ricklon/cam-rotation-starter/drives/n20/cad/stl/README.md

# N20 print files

Exported from the Fusion design *Cam Rotation N20* and oriented for printing (z = 0 is the bed) by [`../fusion/orient_stl.py`](../fusion/orient_stl.py). All files are binary STL in millimetres. `raw/` (not in git) holds the same parts in the model's coordinates.

<!-- parts -->
| Part | Orientation | Size on bed (mm) | Bed contact (mm²) |
|---|---|---|---|
| N20_Mount | flange (wall face) down | 109.0 × 47.2 × 48.6 | 3506 |
| N20_Bushing_075 | flange down | 34.0 × 29.0 × 6.0 | 478 |
| N20_Bushing_0625 | flange down | 34.0 × 29.0 × 6.0 | 574 |
| N20_Bushing_025 | flange down | 34.0 × 29.0 × 6.0 | 765 |
| N20_Cartridge | on its side (-x face down), arms flat along the bed | 35.3 × 29.0 × 15.0 | 282 |
| N20_Electronics_Cover | top plate down, walls and posts up | 42.0 × 55.2 × 12.5 | 2031 |
| N20_Socket_Coupon | socket coupon: plate top down, as the mount | 20.5 × 27.0 × 12.4 | 318 |
| N20_Latch_Key | flat on its side, the U on the bed | 12.2 × 16.7 × 7.0 | 109 |
| N20_Control_Pod | front panel down, open back up | 39.2 × 38.0 × 24.0 | 955 |
| N20_PETG_Fit_Coupon | flat side down, labels up | 100.0 × 44.0 × 6.5 | 3085 |
| N20_Mount_Fit_Coupon_Wall | mount fit coupon: wall top down, as the mount | 32.0 × 11.2 × 36.4 | 192 |
| N20_Mount_Fit_Coupon_Base | mount fit coupon: base inside face down, underside up as on the mount | 37.5 × 35.2 × 4.0 | 1026 |
| N20_Mount_Fit_Coupon_Pod | mount fit coupon: pod front panel down, as the pod | 10.0 × 19.0 × 24.0 | 171 |
| N20_Adapter_075 | D-bore end down, socket up | 25.4 × 25.4 × 24.0 | 462 |
| N20_Adapter_0625 | D-bore end down, socket up | 22.2 × 22.2 × 24.0 | 347 |
| N20_Adapter_025 | D-bore end down, socket up | 12.6 × 12.6 × 24.0 | 99 |
| N20_Adapter_Clamp_0625 | 5/8 clamp, D-bore end down | 26.5 × 24.3 × 24.0 | 347 |
| N20_Adapter_Clamp_025 | 1/4 clamp, socket end down (more bed contact) | 19.9 × 16.3 × 24.0 | 130 |
| N20_Adapter_075_Sleeved | 3/4 sleeved, D-bore end down | 26.5 × 26.5 × 24.0 | 507 |
| N20_Clamp_0625_cap | 5/8 clamp cap, split face down | 26.5 × 17.5 × 12.5 | 163 |
| N20_Clamp_025_cap | 1/4 clamp cap, split face down | 19.9 × 17.5 × 9.2 | 218 |
<!-- /parts -->

Parts the N20 drive shares with the MG90S drive aren't repeated here. Print them from [`drives/mg90s/cad/stl`](../../../mg90s/cad/stl/README.md): `Panel_Fit_Coupon`, the bushings, the dowel gauges and the shims. The N20 drive now has its own control pod (`N20_Control_Pod`, with the J3 connector holder) and its own clamp caps (flat counterbores for M3 cap heads).

**Updated 2026-10-26 (Fusion *Cam Rotation N20* version 10).** Reprint everything in this folder except the plain adapters (`N20_Adapter_075`, `_0625`, `_025`, `_075_Sleeved`), which didn't change. What's new: the motor cartridge, the 14 mm capacitor seat, the diode channel under the base, zip-tie anchors, cap-head clamps, the pod's connector holder, and the PETG fit coupon. `N20_Fit_Coupon` is retired: the cartridge itself and the PETG coupon cover what it tested.

**Added 2026-10-26 (version 11): `N20_Mount_Fit_Coupon_Wall`, `_Base` and `_Pod`,** pieces of the real mount and pod that check the capacitor, diode, board, cartridge, zip-tie and connector fits before the long prints. Nothing else changed.

**Updated 2026-10-27 (version 13): `N20_Mount` only.** The slot between the base and the N20 plate, open at both ends, is now solid, so supports can't get trapped in it (sliced on an A1 with build-plate supports: none there now, and the print drops from about 3 h to 2 h 50 min; 6.6 g more PETG). The cartridge socket and its M3 pilots still cut through it. The wall and base coupon files changed by the same fill. **This fill was wrong until version 19:** see below.

**Updated 2026-10-27 (version 14): snap-fit motor and cartridge.** Reprint `N20_Cartridge` (it now prints on its side) and `N20_Mount` (latch pockets in the socket). New: `N20_Socket_Coupon`, the mount round the socket, to test the latch before the mount. No screws are needed; see [Snap-fit motor](../../README.md#snap-fit-motor-2026-10-27).

**Updated 2026-10-27 (version 15): all six adapters and clamps** (`N20_Adapter_075`, `_0625`, `_025`, `_075_Sleeved`, `_Clamp_0625`, `_Clamp_025`; the caps didn't change). Each has an M3 × 5 set screw that presses on the motor shaft's flat: a 2.5 mm pilot from the bore, with a 3.4 mm access hole to the outside, 2.8 mm above the D-bore end.

**Updated 2026-10-27 (version 16): tighter, locked snap fit.** Reprint `N20_Cartridge`, `N20_Socket_Coupon` and `N20_Mount`. The hooks are set for a 24.1 mm motor (measured), 1.2 mm deep and barbed, with ribs for a zip tie that locks the arms; the latch bumps are 1.4 mm with a steep lower face, in deeper pockets. See [Snap-fit motor](../../README.md#snap-fit-motor-2026-10-27).

**Updated 2026-10-27 (version 18): hard catch on the cartridge latch.** Reprint `N20_Cartridge`, `N20_Socket_Coupon` and `N20_Mount`, and print the new `N20_Latch_Key` (4 min). The latch bumps now have a square catch face, the socket is 0.1 mm tighter a side (`cart_clear` 0.2 mm), and the pockets the bumps click into are now slots open to the top of the base, where the key goes in to release the cartridge. The hooks, arms and zip tie didn't change. Printed and tested on 2026-10-27: the latch holds. See [Snap-fit motor](../../README.md#snap-fit-motor-2026-10-27).

**Fixed 2026-10-27 (version 19): the base-plate slot fill.** From version 13 to 18 the fill started at the bottom of the base instead of its top, so it filled in everything already cut into the base: the DRV8833 pocket and the relief under its pins, the diode channel and its lead slot, and the wire channel under the base on the pod side. It also reached 1.3 mm into the side walls and closed the end of one control pod screw pilot. Now it fills only the slot, from the top of the base to the N20 plate, between the walls. Reprint `N20_Mount`, and `N20_Mount_Fit_Coupon_Base` if you test the board fits with it. A mount printed from version 13–18 files has no DRV8833 pocket or diode channel. `N20_Socket_Coupon` and `N20_Mount_Fit_Coupon_Wall` changed slightly at their edges; ones you've printed still test the same fits. Sliced on an A1 with build-plate supports: none in the slot, the DRV8833 pocket or the diode channel.

**Updated 2026-10-27 (version 20): wiring only, print files unchanged.** The zip ties at anchors A1 and A2 are now modelled in place, and W14 and W15 are routed through A2, so they're cut 55 and 65 mm (were 50 and 60).

**Fixed 2026-11-03 (version 36): `N20_Electronics_Cover` only, mirrored to fit the real board.** The model had the perfboard as its own mirror image (row 1 at +X with column A toward the box wall can't happen on a real board seen from its component side), so covers from versions 33–35 fit RV1 and C3 but had everything else at the wrong end. Now row 17 and both USB-C ports are at −X: the open end, the C1 hole, the posts and the motor notch have moved to match, and the knob hole and C3 hole sit where RV1 and C3 really are. The mount needs no change (all four supports have pilots). Reprint only the cover. W14, W15, W6 and W11 are rerouted, so their cut lengths changed (80, 90, 185 and 185 mm).

**Updated 2026-11-03 (version 34): `N20_Electronics_Cover` again, with the measured sizes.** RV1's shaft is 5 mm above the board and its bushing reaches 5 mm past the board edge, so the knob hole moved down and an Ø11.5 × 0.8 mm recess round it on the outside gives the M7 nut and washer 3.5 mm of thread. C3 is an 8 × 13 mm can like C1, through a 9 mm hole. Reprint the cover from this version.

**Updated 2026-11-08 (version 38): `N20_Cartridge` only.** Both snap hooks now stop 24.8 mm below the gearbox face, so an N20 with a Hall encoder board on its back (the board's front face is about 25 mm from the gearbox face) fits. The −Y arm stops at the same height, because the encoder board runs under it. The catch is unchanged, but the sloped lead-in under each hook is gone: spread the arms with your fingers as the motor goes in. The plain N20 still fits. See [Encoder motor](../../README.md#encoder-motor-2026-11-08). The wire clamp below the +Y arm stays on the part but isn't used with the encoder motor: its cable plugs into the encoder, so nothing is soldered at the motor.

**Updated 2026-11-08 (version 39): wiring only, print files unchanged.** The encoder motor's cable, the links W30 and W31 and C2 on the perfboard are routed in the model. The cable comes out through the cover's existing 7 mm notch.

**Updated 2026-11-09 (version 41): `N20_Cartridge` only, fingers round the encoder board.** The version 38 print wouldn't clip over the encoder motor: its hooks had to drop into a gap of under 1 mm between the end cap and the board, which sits tilted 25–25.5 mm from the gearbox face. Now the −Y arm has no end-cap hook. Instead, two fingers (1.2 mm wide, split from the arm up to 15 mm below the gearbox face) pass the board's sides, 0.3 mm clear, and catch its back 26.6 mm from the gearbox face, 0.8 mm in, with a sloped lead-in, so they spread as the board goes past. The +x finger's catch is tapered at 45° so it prints without supports. The +Y arm keeps its end-cap hook, now with a 0.5 mm lead-in again (more would hit the board). The fingers flex across the layers, unlike the arms; the strain is under 1 %, but if one snaps, tell me. Clearances: 0.2 mm to the board, 0.3 mm to the magnet cap. With the plain N20 (no board), only the +Y hook holds it.

**Updated 2026-11-03 (version 35): `N20_Mount` only.** The bushing's flange recess has moved from the underside of the top plate to the flat wall face: the bushing drops into the bore from the wall side, its Ø34 mm double-D flange sits in a 1.6 mm deep recess (flange 1.5 mm, so it sits 0.1 mm below the face), and the box wall holds it in once the mount is screwed on. Nothing has to slide in under the plate any more, where the 5/8 clamp left no room. The old recess under the plate is filled. Bore (Ø29.2 mm), bushing and dowel bores are unchanged, so the bushings don't need reprinting; reprint only the mount. The recess is on the bed face: its ceiling is a 2.6 mm ring overhang round the bore, which prints without supports. The box wall hole now only needs to pass the dowel: the dowel and its clamp go through the mount, then the bushing, before the mount goes on the wall (see the [assembly order](../../README.md#assembly-order-and-tool-access)). The MG90S drive has the same change (*Cam Rotation Starter* version 51).

**Updated 2026-11-03 (version 33): `N20_Electronics_Cover` only.** Fitted to the board as built: RV1 stands with its shaft parallel to the board, pointing off the J edge, and C3 stands. The cover's J-edge wall moved in to just past RV1's face and carries the Ø7.2 mm knob hole; the top has a notch for RV1's body and a hole for C3's top; the C1 hole, the USB-C opening, the posts and the motor notch stay. It still prints top plate down with no supports (the knob hole is a horizontal Ø7.2 mm hole in a wall). RV1 and C3 sizes are assumed until measured: see `cad/fusion/cover_rv1.py`.

**Updated 2026-11-02 (version 31): `N20_Mount` and the new `N20_Bushing_075`, `_0625`, `_025`.** the mount's top-plate bore is Ø29.2 mm so the assembled 5/8 clamp, with its M3 cap heads (14.3 mm swept), drops through from above. The N20 bushings are Ø29.0 mm outside with a Ø34 mm double-D flange (flats 28.8 mm apart, parallel to the side walls), retained from below. (From 2026-11-03 the MG90S drive has the same bore and bushings, so they're a shared part again; `N20_Bushing_*` here and the MG90S `Bushing_*` are the same.) Dowel bores unchanged. Box wall hole: Ø20 mm is enough if the dowel and clamp go through the mount before it's screwed to the box; to push them in from inside the box with the drive already mounted, the box hole needs ≥ Ø29.2 mm (a 30 mm bit). Print the bushings from either folder.

**Updated 2026-11-02 (version 30): `N20_Control_Pod` and `N20_Mount_Fit_Coupon_Pod`.** The direction switch and the J3 panel connector are gone, so the pod has no JST header holder; the button's wires run straight to the perfboard. The holder was what needed tree supports in the pod: slice it and check before you turn supports off. Skip `N20_Mount_Fit_Coupon_Pod` now: it only checked the holder.

**Updated 2026-11-02 (version 29): `N20_Mount`, `N20_Electronics_Cover` and `N20_Mount_Fit_Coupon_Wall`.** C1 now stands on the perfboard, so the capacitor seat in the mount's −Y wall is gone (filled in), and the cover has a 9 mm hole for the can's top. The wall coupon is cut from the mount, so it lost the seat too; ignore the capacitor checks below.

**Updated 2026-11-01: `N20_Cartridge` only.** The wire clamp is sized for the motor's own leads (assumed 26 AWG, about 1.0 mm) instead of 30 AWG: the bar between its two zip-tie slots is 2.4 mm (was 1.4 mm), and the plate is 1 mm longer so the lower slot keeps a 1 mm edge. Reprint the cartridge.

**Updated 2026-10-31 (version 25): rev C.** Reprint `N20_Mount` and `N20_Cartridge`, and print the new `N20_Electronics_Cover`. The socket and mount fit coupons didn't change.

- **`N20_Mount`:** supports for the perfboard on the −Y face: two posts from the flange, two bosses with 45° gussets, and a rail past the face's +X edge, all with M2 pilots. The flange ear is unchanged.
- **`N20_Cartridge`:** a wire clamp plate below the +Y snap arm, with two slots for a 2.5 mm zip tie (for the plain N20's soldered leads; the encoder motor doesn't use it).
- **`N20_Electronics_Cover`:** goes over the perfboard as the mount's outer −Y wall, open at the −X end for both USB-C plugs, and carries the speed knob.

The supports print up from the flange without supports of their own. See [What changed on 2026-10-31](../../README.md#what-changed-on-2026-10-31-rev-c).

## Test prints, in order

Each step checks something before you commit to a longer print. Print these in PETG if that's what the full build will be: PETG holes come out a little different from PLA's.

### 1. `N20_PETG_Fit_Coupon` (about 15 g)

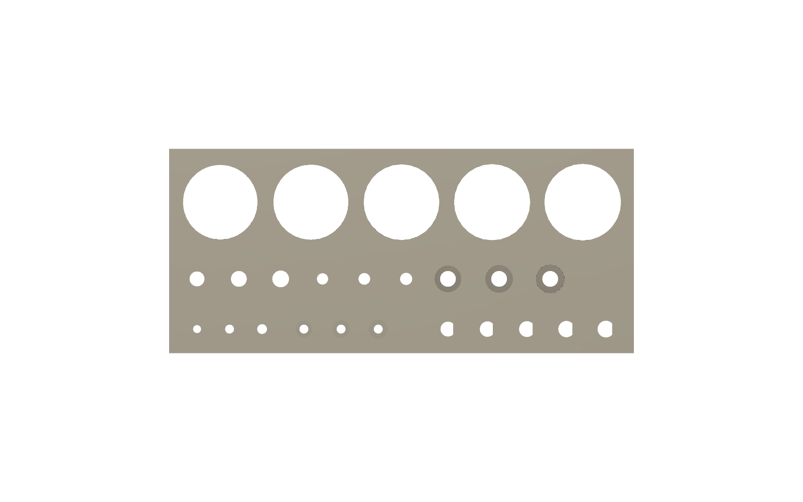
[picture p5: drives/n20/docs/images/petg_fit_coupon.png]
The PETG fit coupon from above: five large 5/8" holes along the top, a row of M3 holes below them, and a strip of small M1.6 holes and D-shaped bores along the bottom, each with its size engraved underneath.


Every hole has its size engraved under it. Find the one that fits in each row and note it.

| Row | Labels | Check | Then set |
|---|---|---|---|
| 5/8" dowel | +0.2 … +0.6 (mm over 15.875) | The hole the dowel **slides and turns in** freely is the bushing clearance; the one it **pushes into snugly** is the adapter socket clearance. | `hole_clear` (0.5) and `fit_clear` (0.3) |
| M3 clearance | C3.2, C3.4, C3.6 | The smallest an M3 screw drops through. | `clamp_clear` and `cart_m3_clear` (3.4) |
| M3 pilot | P2.4, P2.5, P2.6 (6.5 mm deep) | Drive an M3 × 8 in: it should cut its thread firmly without splitting the plastic. | `clamp_pilot` (also the adapters' shaft set screw) and `cart_m3_pilot` (2.5) |
| M3 cap head | H5.8, H6.0, H6.2 (3.2 mm deep) | The socket cap head drops in and sits flat, flush or just below. | `clamp_cbore` (6.0) |
| M1.6 clearance | 1.7, 1.9, 2.1 (in the 3 mm strip) | The smallest an M1.6 screw drops through. | `m16_clear` (1.9) |
| M1.6 counterbore | c3.6, c3.8, c4.0 (1.5 mm deep) | Pan head on a split lock washer sits flush. | `m16_cbore` (3.8) |
| D-bore | .10 … .30 (clearance per side) | Push the motor shaft in, flat to flat: the one that goes on by hand without wobble. | `n20_bore_clear` (0.15) |

### 2. `N20_Cartridge`, `N20_Socket_Coupon` and `N20_Latch_Key` (about 22 + 15 + 4 min, 3 + 5 + 1 g)

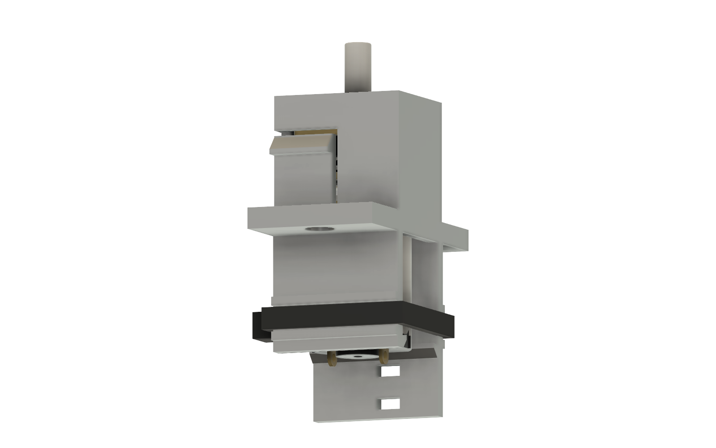
[picture p6: drives/n20/docs/images/cartridge.png]
The cartridge with the motor in it, from the side: the shaft out of the top plate, a latch tongue cut into the side wall with its bump near the top, the flange, and below it a snap arm along the motor with its hook over the end cap, and a black zip tie round both arms between their ribs.


Print them the way they load, with no supports: the cartridge lies on its side, the socket coupon on its plate face like the mount, the key flat. The coupon is the mount's own socket, cut out of it, so a latch that holds here holds in the mount. The catch face in each slot prints as a short bridge. **The cartridge needs no supports; turn them off for it.** Most of its overhang is one flat ceiling, the far wall of the gearbox cavity, which prints as a 10.6 mm bridge across the inside of the tube. Everything else is a short bridge (the zip-tie slots, the 0.5 mm slots beside the encoder fingers) or a 45° slope. Standard (grid) supports fill the motor cavity and the finger slots and are close to impossible to get out. If your bridge sags and you want support under it, use organic (tree) supports from the build plate only, and if your printer has a second material, print the support interface in PLA: PLA doesn't bond to PETG, so it peels off. **Before printing, measure your motor** from the gearbox face to the back of the end cap. The hooks are set for 24.1 mm (`n20_len`), so tell me if yours differs.

| Check | If it's wrong |
|---|---|
| The motor pushes up into the cartridge until its gearbox face meets the top plate, and both arms click over the end cap. It shouldn't rattle up and down. | Won't click: the motor is longer than `n20_len`. Rattles: it's shorter. Measure it and tell me. Gearbox tight in the sleeve: raise `n20_clear` (0.3 mm). |
| Pulling the motor down (without the zip tie) doesn't release it: the barbed hooks hold. Spreading both arms by hand does, without the arms whitening or staying bent. | Releases on a pull: tell me, the barb or hook depth can grow. Arms whiten: they can be made longer or thinner. |
| A 2.5 mm zip tie sits between the two ribs on the arms (the dark band in the picture above) and, pulled tight, stops them spreading at all. | Tie slips over a rib: tell me, the ribs can be taller. |
| The **empty** cartridge pushes up into the socket coupon until both latches click and the flange sits flat, with almost no up-and-down or side-to-side play. Looking down into the two slots in the top, you can see both bumps. | Too stiff or won't click: tell me how it felt; the bumps or the tongue slits can change. Won't go in at all: the socket is too tight for your printer; `cart_clear` can go back up. |
| **Pull test, empty:** hold the coupon and pull the cartridge down hard by its flange. It shouldn't come out. | It comes out: tell me whether the bumps or the ledges in the slots look rounded or crushed. |
| **Pull test, motor in:** fit the motor and zip tie, then hang about 1 kg (a full 1 L water bottle) from the motor, or pull on it as hard as you would in class. Nothing moves. | It comes out: tell me which gave way: the bumps, the ledges, or the motor out of the cartridge. |
| **Release:** motor out, push the key down into both slots until it stops; the cartridge then slides out of the socket from below with a light pull. | Key won't go in: the slots or prongs are tight; tell me. Cartridge still holds: the key isn't pressing the tongues in far enough; tell me. |

### 3. `N20_Mount_Fit_Coupon_Wall`, `_Base` and `_Pod` (about 13 g together)

Three pieces cut from the real mount and pod in Fusion (boxes intersected with them, so they follow every change to either). Together they check every fit on the long prints before you commit to them.

**Print each file the way it loads; don't use lay flat or auto-orient.** Each piece is already the same way up as the full part it comes from, which is what makes its holes and pockets come out the same size: the wall piece stands on the top of the wall (like the mount, flange down), the base piece lies on the base's inside face with its underside up (as on the mount), and the pod piece stands on its front panel (like the pod). Turning them over to get more bed contact would test the wrong thing.

| File | Supports | Time on an A1 (PETG, 0.2 mm) |
|---|---|---|
| `N20_Mount_Fit_Coupon_Wall` | none | about 32 min |
| `N20_Mount_Fit_Coupon_Base` | none | about 16 min |
| `N20_Mount_Fit_Coupon_Pod` | **tree supports, allowed on the model** (not build plate only): the connector holder starts in mid-air over the front panel | about 16 min |

| Piece | Check | If it's wrong |
|---|---|---|
| Wall piece | The capacitor snaps into its seat. The XIAO drops into its pocket, with its soldered wire ends in the 2.5 mm relief under each pin row. The PD board drops into its seat on the pad and rests on the 1 mm ledge, its bottom-side parts clear of the recess floor. Your zip ties go through the XIAO's and the PD board's slots, and round the bar in anchor A1 at the bottom of the wall. | Capacitor: `c1_seat_dia`. Boards: `board_clear` (0.3 mm), `solder_relief_d` (2.5 mm), `pd_relief_d` (3.5 mm). |
| Base piece | The motor cartridge slides through the socket (here only the 4 mm base) and its flange sits flat on the base; the M3 pilots line up with the flange holes (their depth is tested on the PETG coupon). The DRV8833 drops into its pocket with its wire ends in the relief. The diode lies in its channel with its lead in the slot to the DRV8833 pocket. A zip tie goes round the bar in anchors A1 and A2. | Cartridge: `n20_clear`, `cart_m3_pilot`. DRV8833: `board_clear`, `solder_relief_d`. |
| Pod piece | Nothing from version 30: it only checked the JST-PH header holder, which is gone. | Skip it. |

### 4. `Panel_Fit_Coupon` and the dowel gauges (from the MG90S folder)

Skip these if you've done them for the MG90S drive. Follow steps 1 and 3 of the [MG90S print order](../../../mg90s/cad/stl/README.md#print-order-for-a-fit-test).

### 5. One adapter for your dowel

Print the adapter for the dowel you'll use (`N20_Adapter_075`, `_0625` or `_025`; the clamp version plus its cap if the dowel is sanded). Check that it slides onto the motor shaft with the flat lined up, and that the dowel pushes into the socket snugly. Then drive the M3 × 5 set screw in with a 1.5 mm hex key: it should cut its thread and pinch the shaft's flat so the adapter can't turn on it, without stripping.

### 6. `N20_Mount` and `N20_Control_Pod` (the long prints)

Only once steps 1, 2, 3 and 5 fit. The fit coupon has already checked the fits below; on the full mount, look for the things a coupon can't show: the face plate bridged cleanly, the flange is flat, and the PD pad's overhang printed cleanly. Then check the mount after printing:

- the empty cartridge clicks up into the socket in the base and its flange sits flat under the base;
- the capacitor snaps into its seat beside the XIAO pocket;
- the diode lies in the channel under the base, and its lead slot runs from the wall edge to the DRV8833 pocket;
- the zip-tie anchors are open: two small slots with a bar between them, joined by a tunnel inside the base, under the electronics-side wall (A1) and beside the DRV8833 pocket on the pod side (A2). They're the only tie holes under the base; the two round holes beside the socket are the M3 pilots for the optional cartridge screws;
- the DRV8833 pocket and the 2.5 mm relief slots under its pin rows (and under the XIAO's) are clean;
- the PD board drops into its seat in the pad and rests on the 1 mm ledge round its edges.

In the pod, check that the button fits its hole. (Up to version 29 the pod also had a holder for the J3 header; it's gone.)

### What to send back

Tell me which hole fitted in each row of the PETG coupon, how the cartridge snaps felt, how each part sat in the mount fit coupon, and anything that was tight or loose. I'll set the parameters in Fusion and re-export.

## Suggested settings

| Part | Material | Layer | Walls | Infill | Supports |
|---|---|---|---|---|---|
| N20_PETG_Fit_Coupon | PETG | 0.2 mm | 3 | 20% | none |
| N20_Cartridge | PETG (not PLA: the arms, fingers and latch tongues flex) | 0.16 mm | 3 | 40% | **none**: printed on its side (as the file loads), so the snap arms and latch tongues bend along their layers (the encoder fingers bend across them, gently). See the cartridge notes in section 2 if your slicer adds supports. |
| N20_Socket_Coupon | PETG | 0.2 mm | 3 | 25% | none (same settings as the mount) |
| N20_Latch_Key | PETG | 0.16 mm | 3 | 40% | none: printed flat, as the file loads |
| N20_Mount_Fit_Coupon_Wall, _Base | PETG | 0.2 mm | 3 | 25% | none (same layer, walls and infill as the mount, so its fits come out the same) |
| N20_Mount_Fit_Coupon_Pod | PETG | 0.2 mm | 3 | 20% | **tree supports, allowed on the model**, as for the pod |
| Adapters, clamps, caps | PETG | 0.12–0.16 mm | 4 | 40% | none |
| N20_Control_Pod | PETG | 0.2 mm | 3 | 20% | **tree supports, allowed on the model** (not build plate only): printed front panel down, the JST holder starts in mid-air above the front panel's inside face |
| N20_Mount | PETG | 0.2 mm | 3 | 25% | **yes**, build plate only: under the face plate (through the bushing hole) and the PD pad. The ear bosses print upright from the flange and need none. |
| N20_Electronics_Cover | PETG | 0.2 mm | 3 | 20% | none: printed top plate down, as the file loads |

PETG notes: print a little slower and hotter than PLA, turn off ironing, and use a glue stick or textured sheet on smooth PEI (PETG can bond too well). Where a part needs supports, organic (tree) supports come off far more easily than standard ones, and with a two-material printer a PLA support interface (or all-PLA supports) separates cleanly from PETG. Holes usually come out slightly smaller than in PLA, which is what the coupon is for.

Printed flange down, the mount's face plate is a 29 mm bridge between the side walls, now with the cartridge socket through it. The supports under it stand in the open space the adapter turns in and come out through the open ends; the narrower slot above the plate, under the base, is filled solid so nothing gets trapped there. If yours sags, turn on supports everywhere (not just from the build plate) for that print. The PD board's pad also leaves a 3.5 mm overhang facing the bed; build-plate supports reach it.

## Fitting the motor, the driver and the panel

The full order, with the tool for each step, is in the drive's [assembly order](../../README.md#assembly-order-and-tool-access).

- **Motor:** no screws. The empty cartridge clicks up into the socket in the base, then the motor pushes up into the cartridge, its shaft into the adapter's D-bore, until the arms click over its end cap, and a zip tie round the arms locks it. The M1.6 counterbores and M3 flange holes are still there if a snap ever needs backing up with screws.
- **Shaft set screw:** one **M3 × 5** set screw in every adapter and clamp, near the D-bore end, tightened onto the shaft's flat with a 1.5 mm hex key through an open end of the mount once the motor is in.
- **Clamps:** two **M3 × 8** socket cap screws per clamp, heads in the flat counterbores on the cap. Turn the cap toward an open end of the mount to reach them with a 2.5 mm hex key. With the screws tight, the 5/8 clamp sweeps 14.3 mm from the axis, inside the 0.6 mm relief in both side walls (15.3 mm). Don't use M3 × 10: on the 5/8 clamp the tip would come out of the side.
- **DRV8833 module:** solder its wires first, then stick it into the pocket on the underside of the base with a square of double-sided foam tape, component side out. Leave its **J1** jumper open.
- **Diode:** lay it in its channel under the base with the banded end toward the wall, bend the cathode lead round the edge and up to the XIAO's 5V pad, and run the anode lead along its slot to the DRV8833's VCC pin. A dab of glue holds it.
- **Capacitor:** from version 29, C1 stands on the perfboard (see [perfboard.md](../../docs/perfboard.md#placement)); the mount has no seat for it.
- **Control panel connector (J3):** gone from version 30. The button's two wires run straight to the perfboard (see [wiring.md](../../docs/wiring.md#the-button-s1)).
- **Zip ties:** one through anchor A1 round the two power wires under the wall, one through A2 round the two motor wires under the base, and one round the cartridge's motor arms between their ribs.
