ricklon/cam-rotation-starter/drives/n20/docs/images/perfboard.png

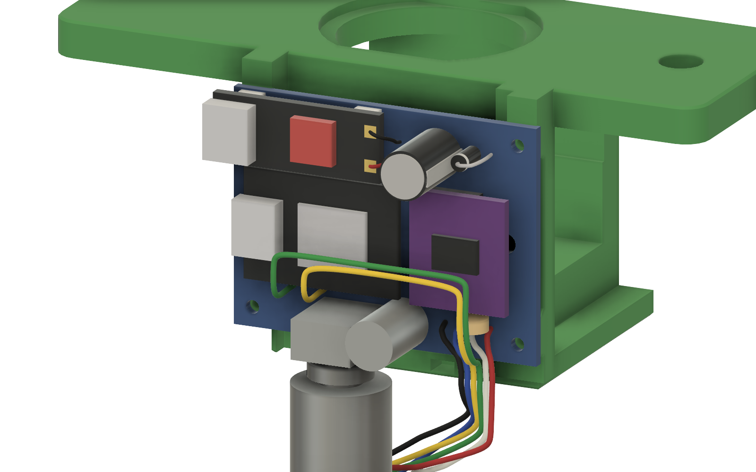
drives/n20/docs/images/perfboard.png
