ricklon/cam-rotation-starter/drives/mg90s/cad/stl/Servo_Mount.stl

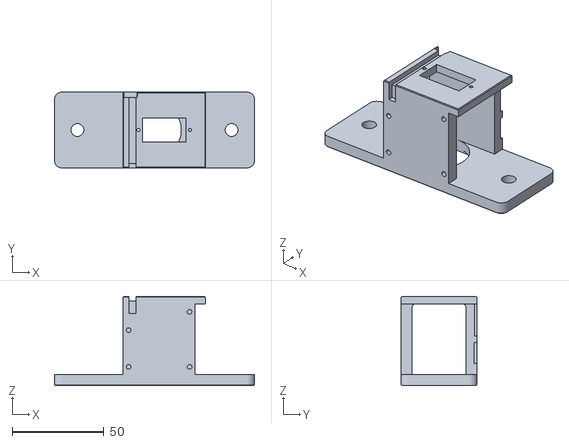
[picture p10: CAD file, 2026-11-03]
drives/mg90s/cad/stl/Servo_Mount.stl
109.0 x 41.3 x 48.6
