ricklon/cam-rotation-starter/drives/n20/cad/solidcraft/pipeline/v22/fusion_ref/Adapter_075_Sleeved.step

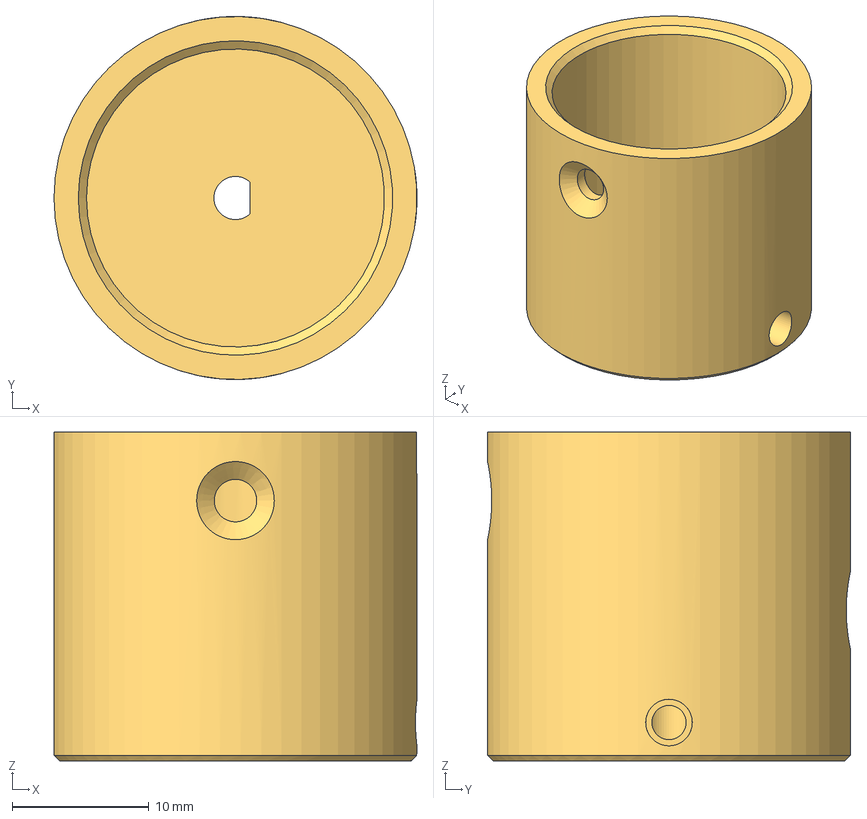
[picture p11: CAD file, 2026-10-29]
drives/n20/cad/solidcraft/pipeline/v22/fusion_ref/Adapter_075_Sleeved.step
26.5 x 26.5 x 24.0 mm
