ricklon/cam-rotation-starter/drives/n20/cad/solidcraft/repros/06_fusion_Adapter_025.step

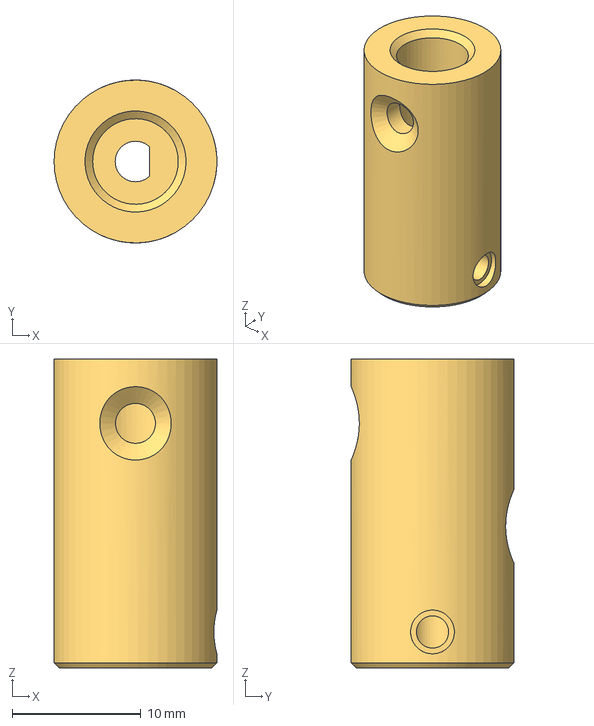
[picture p12: CAD file, 2026-10-29]
drives/n20/cad/solidcraft/repros/06_fusion_Adapter_025.step
12.6 x 12.7 x 24.0 mm
