ricklon/cam-rotation-starter/drives/n20/cad/step/cam-rotation-n20.step

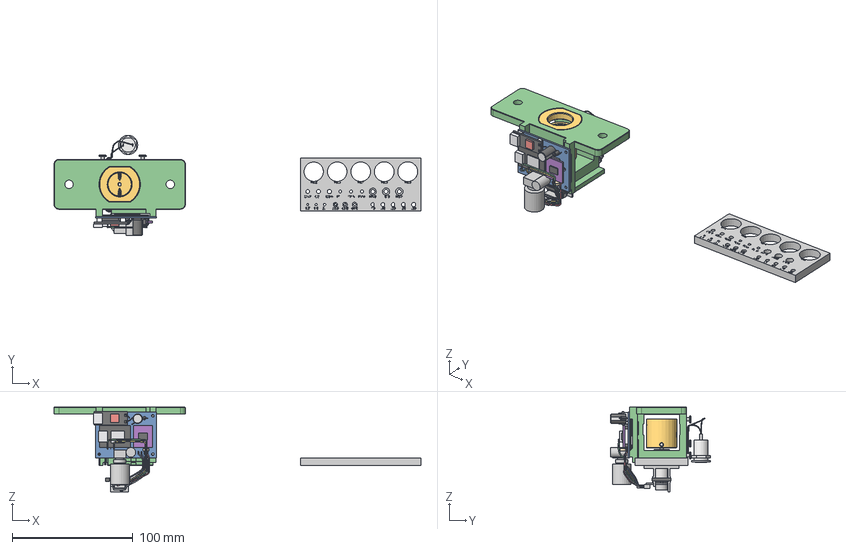
[picture p13: CAD file, 2026-11-10]
drives/n20/cad/step/cam-rotation-n20.step
304.5 x 83.3 x 70.5 mm
M3x8 Wafer Head v1 (3).step x 4
N20 DC MOTOR
