ricklon/cam-rotation-starter/drives/n20/cad/stl/N20_Cartridge.stl

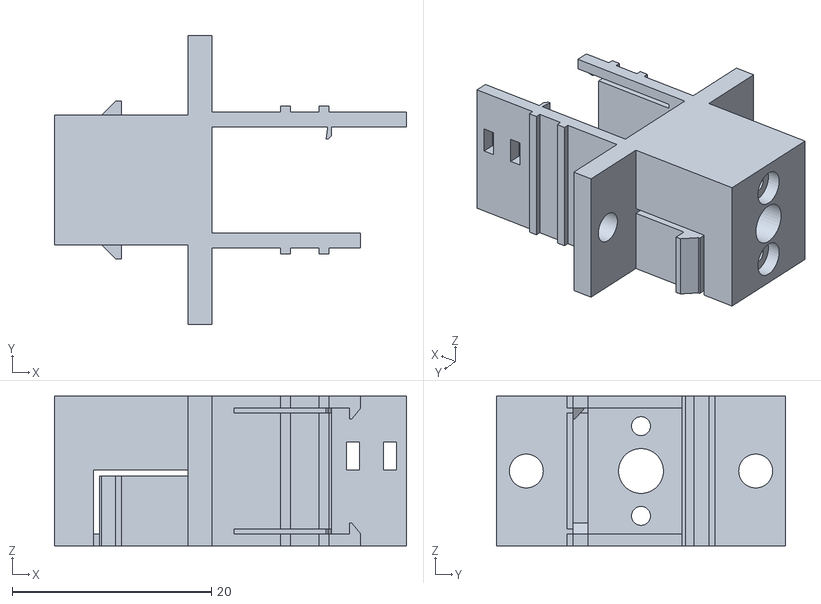
[picture p14: CAD file, 2026-11-10]
drives/n20/cad/stl/N20_Cartridge.stl
35.3 x 29.0 x 15.0
