ricklon/cam-rotation-starter/drives/mg90s/cad/stl/Bushing_075.stl

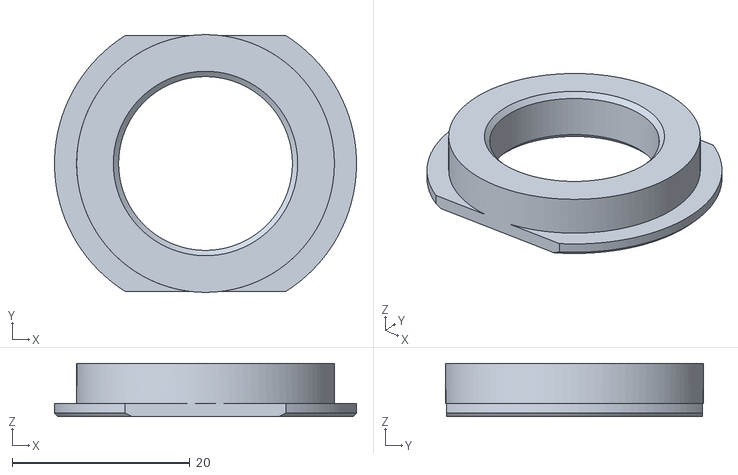
[picture p15: CAD file, 2026-11-03]
drives/mg90s/cad/stl/Bushing_075.stl
34.0 x 29.0 x 6.00
