ricklon/cam-rotation-starter/drives/n20/cad/solidcraft/pipeline/v22/fusion_ref/Servo_Mount.step

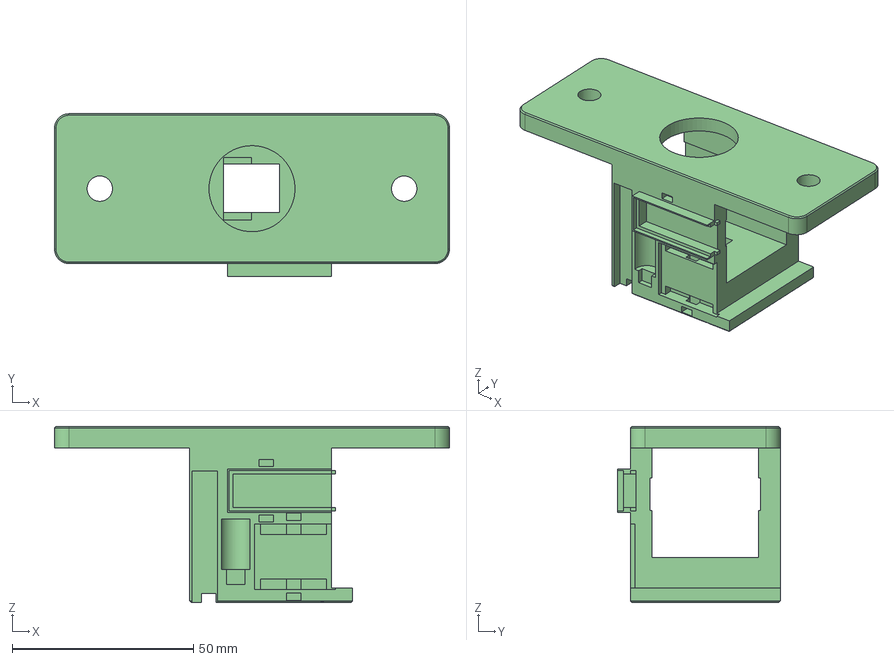
[picture p16: CAD file, 2026-10-29]
drives/n20/cad/solidcraft/pipeline/v22/fusion_ref/Servo_Mount.step
109.0 x 44.8 x 48.6 mm
