ricklon/cam-rotation-starter/drives/n20/cad/stl/N20_Electronics_Cover.stl

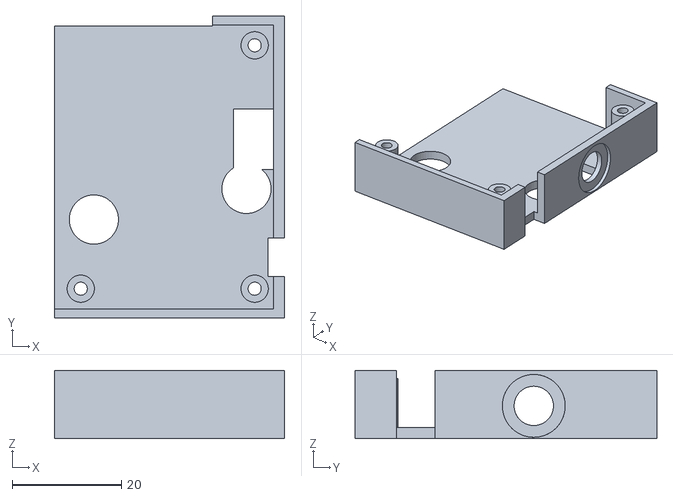
[picture p17: CAD file, 2026-11-03]
drives/n20/cad/stl/N20_Electronics_Cover.stl
42.0 x 55.2 x 12.5
