ricklon/cam-rotation-starter/drives/n20/cad/solidcraft/pipeline/v22/fusion_ref/Adapter_075.step

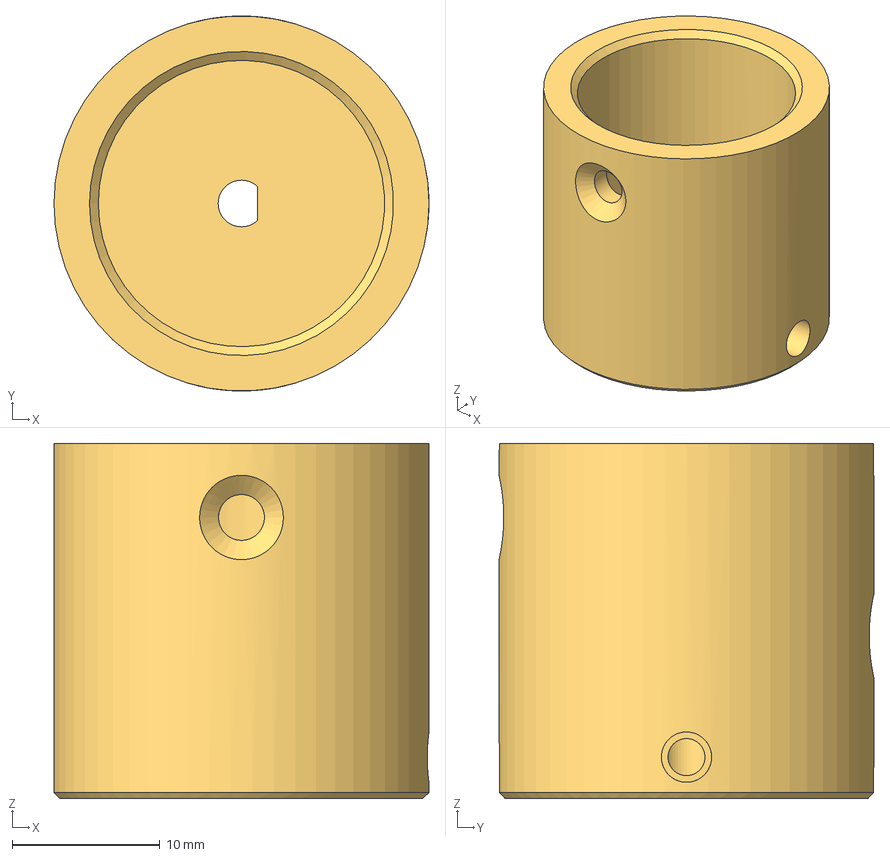
[picture p19: CAD file, 2026-10-29]
drives/n20/cad/solidcraft/pipeline/v22/fusion_ref/Adapter_075.step
25.4 x 25.3 x 24.0 mm
