ricklon/cam-rotation-starter/drives/n20/cad/stl/N20_Mount.stl

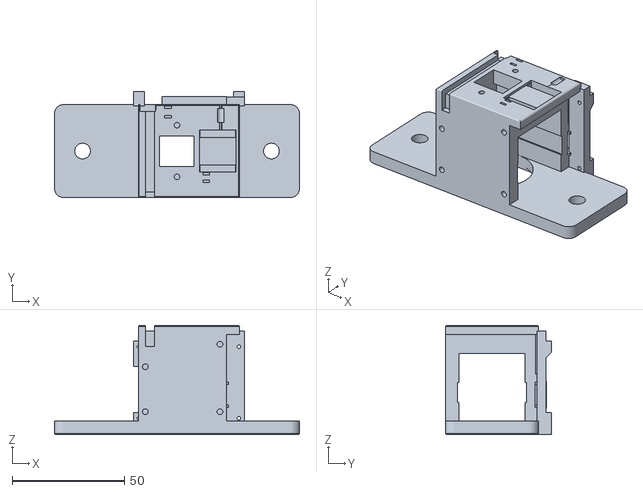
[picture p20: CAD file, 2026-11-03]
drives/n20/cad/stl/N20_Mount.stl
109.0 x 47.2 x 48.6
