ricklon/cam-rotation-starter/drives/n20/cad/solidcraft/pipeline/v22/fusion_ref/N20_Cartridge.step

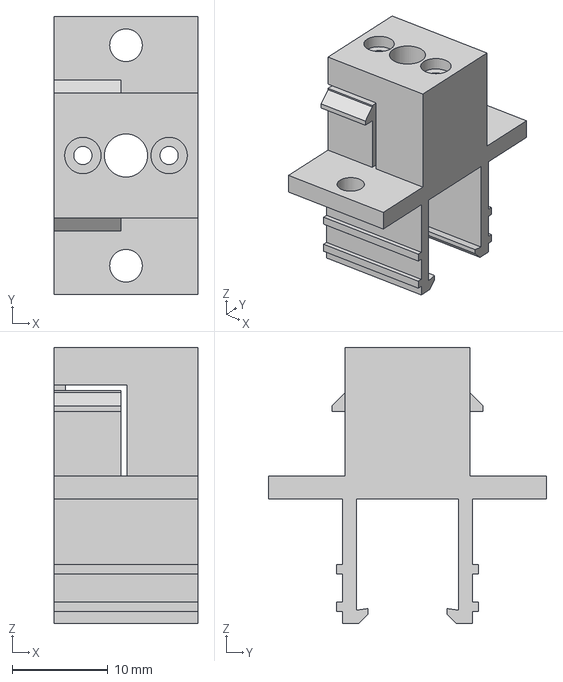
[picture p22: CAD file, 2026-10-29]
drives/n20/cad/solidcraft/pipeline/v22/fusion_ref/N20_Cartridge.step
15.0 x 29.0 x 28.8 mm
