ricklon/cam-rotation-starter/drives/n20/cad/stl/N20_Mount_Fit_Coupon_Wall.stl

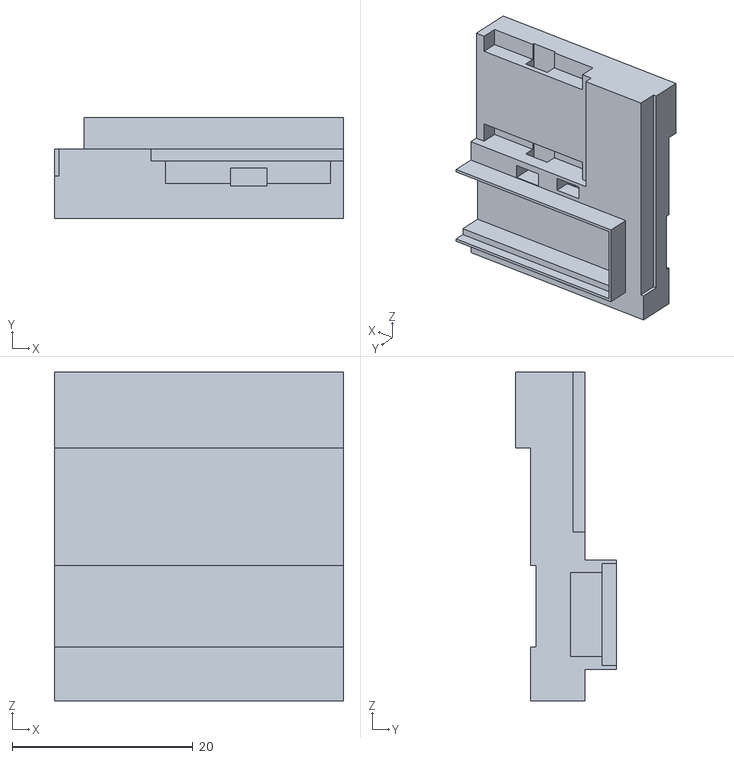
[picture p23: CAD file, 2026-11-03]
drives/n20/cad/stl/N20_Mount_Fit_Coupon_Wall.stl
32.0 x 11.2 x 36.4
