ricklon/cam-rotation-starter/drives/mg90s/cad/stl/Adapter_Clamp_0625.stl

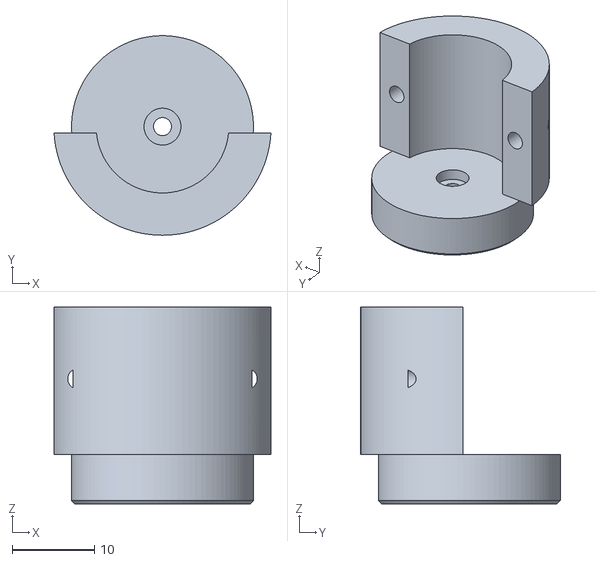
[picture p24: CAD file, 2026-10-24]
drives/mg90s/cad/stl/Adapter_Clamp_0625.stl
26.5 x 24.3 x 24.0
