ricklon/cam-rotation-starter/drives/n20/cad/solidcraft/pipeline/v22/fusion_ref/N20_Latch_Key.step

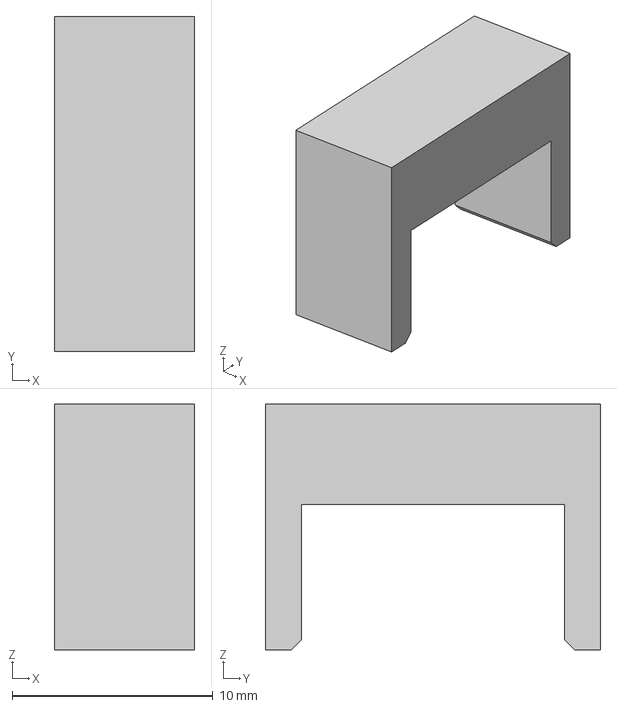
[picture p25: CAD file, 2026-10-29]
drives/n20/cad/solidcraft/pipeline/v22/fusion_ref/N20_Latch_Key.step
7.00 x 16.7 x 12.2 mm
