ricklon/cam-rotation-starter/drives/n20/cad/stl/N20_Mount_Fit_Coupon_Pod.stl

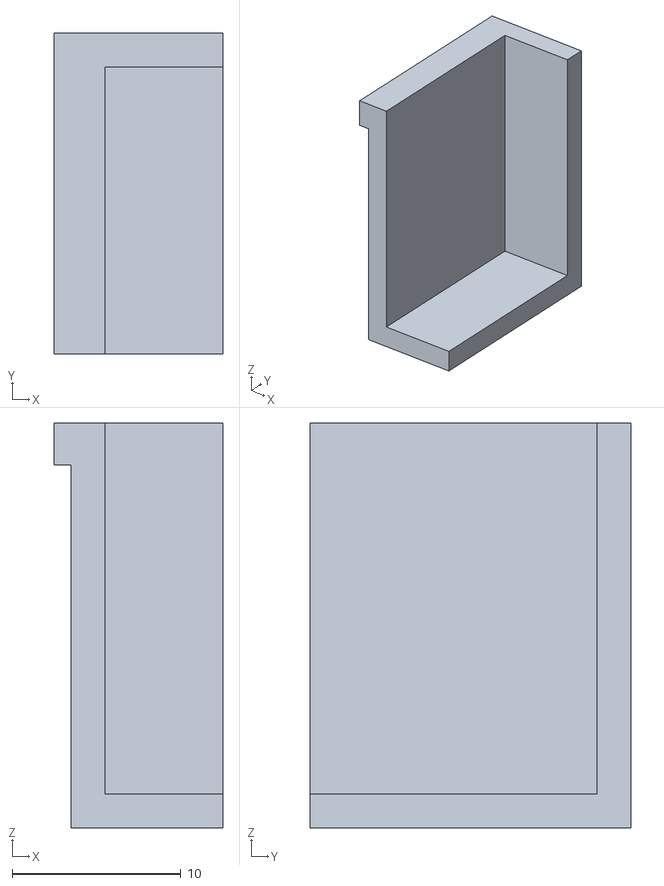
[picture p26: CAD file, 2026-11-03]
drives/n20/cad/stl/N20_Mount_Fit_Coupon_Pod.stl
10.0 x 19.0 x 24.0
