ricklon/cam-rotation-starter/drives/mg90s/cad/stl/Clamp_0625_cap.stl

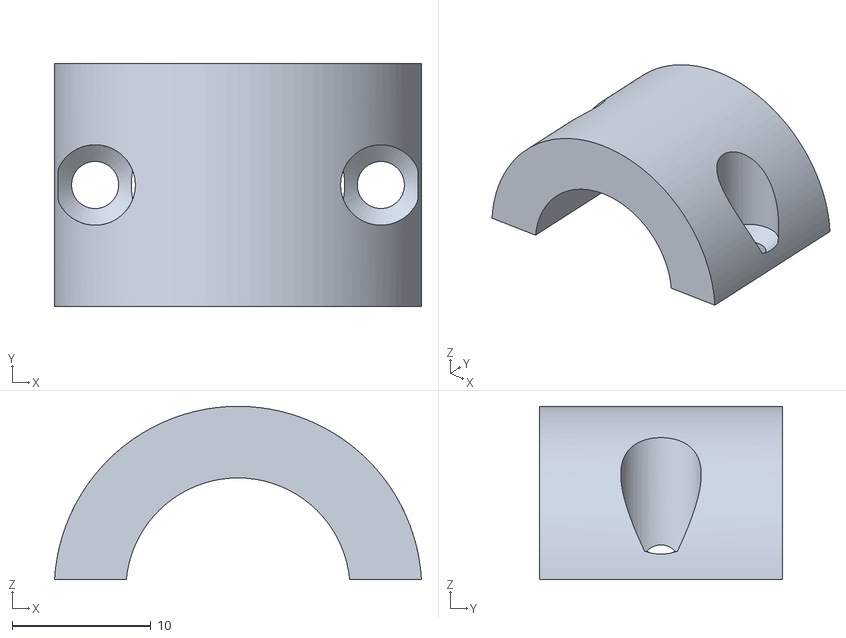
[picture p27: CAD file, 2026-10-24]
drives/mg90s/cad/stl/Clamp_0625_cap.stl
26.5 x 17.5 x 12.5
