ricklon/cam-rotation-starter/drives/n20/cad/solidcraft/pipeline/v22/fusion_ref/Adapter_Clamp_0625.step

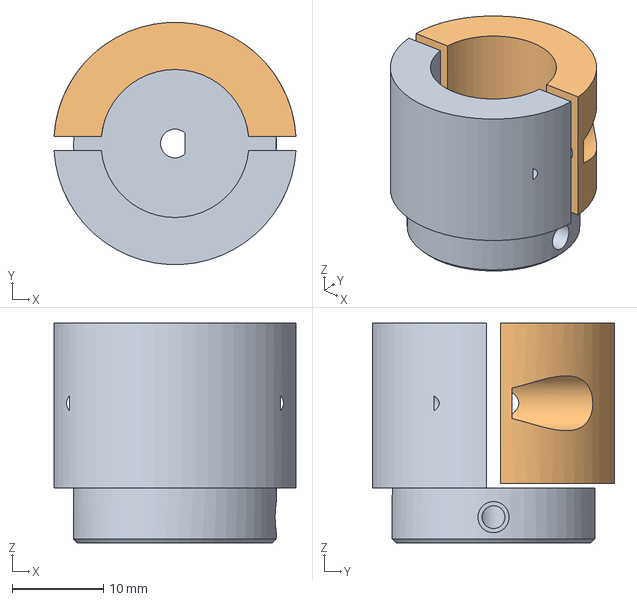
[picture p28: CAD file, 2026-10-29]
drives/n20/cad/solidcraft/pipeline/v22/fusion_ref/Adapter_Clamp_0625.step
26.5 x 26.5 x 24.0 mm
