ricklon/cam-rotation-starter/drives/mg90s/cad/stl/Adapter_Clamp_025.stl

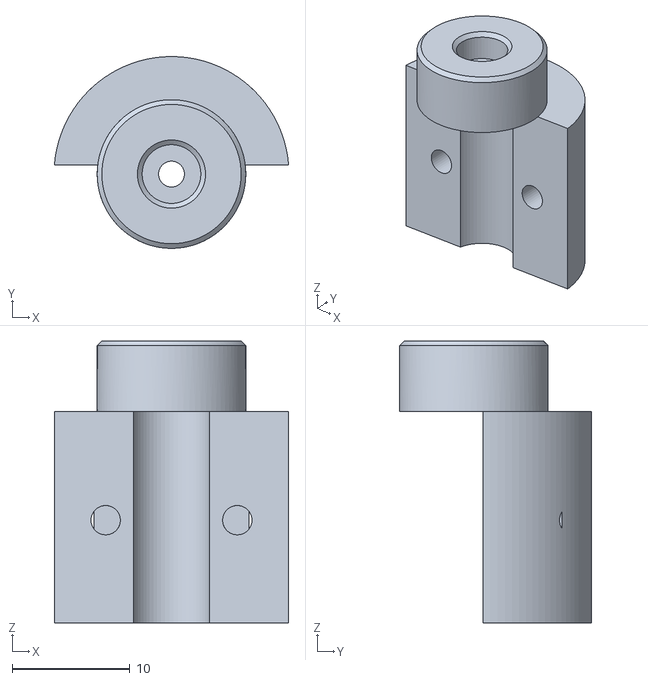
[picture p29: CAD file, 2026-10-24]
drives/mg90s/cad/stl/Adapter_Clamp_025.stl
19.9 x 16.3 x 24.0
