ricklon/cam-rotation-starter/drives/n20/cad/solidcraft/pipeline/v22/fusion_ref/Adapter_0625.step

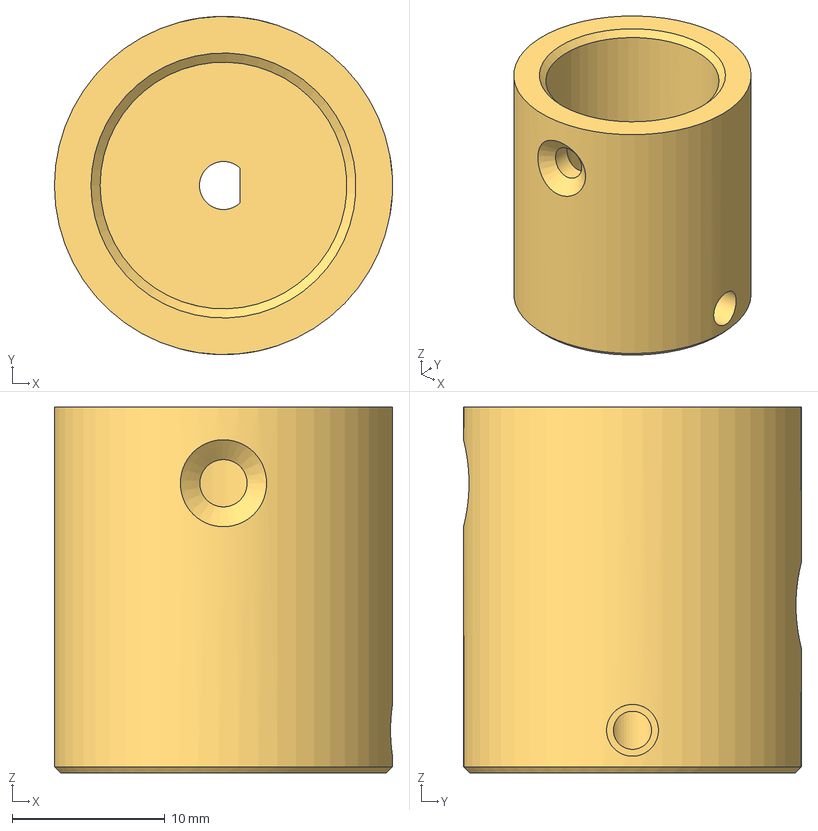
[picture p30: CAD file, 2026-10-29]
drives/n20/cad/solidcraft/pipeline/v22/fusion_ref/Adapter_0625.step
22.2 x 22.2 x 24.0 mm
