ricklon/cam-rotation-starter/drives/mg90s/cad/stl/Clamp_025_cap.stl

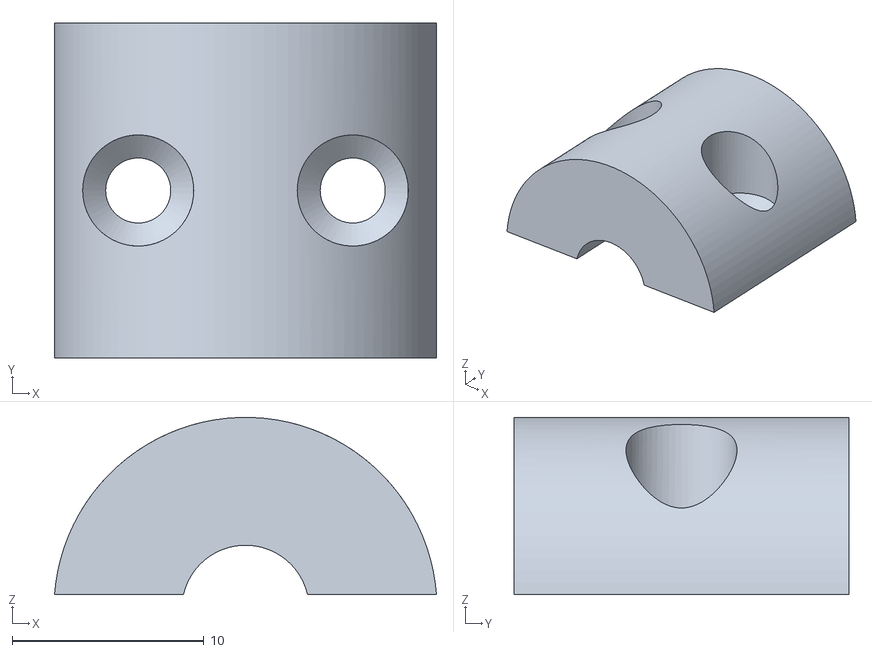
[picture p31: CAD file, 2026-10-24]
drives/mg90s/cad/stl/Clamp_025_cap.stl
19.9 x 17.5 x 9.24
