ricklon/cam-rotation-starter/drives/n20/cad/solidcraft/pipeline/v22/fusion_ref/Adapter_Clamp_025.step

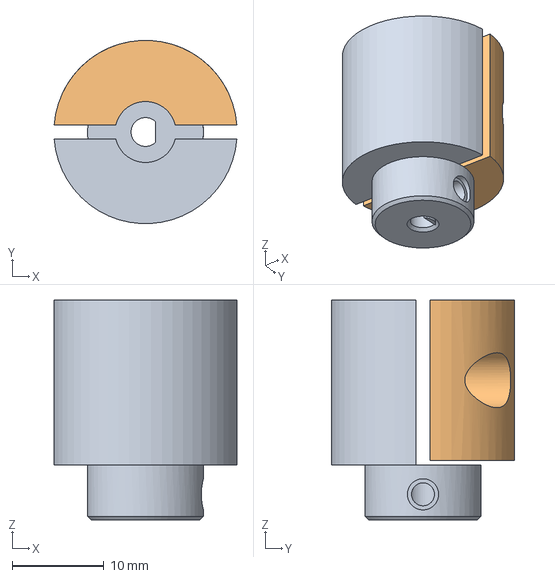
[picture p32: CAD file, 2026-10-29]
drives/n20/cad/solidcraft/pipeline/v22/fusion_ref/Adapter_Clamp_025.step
19.9 x 20.0 x 24.0 mm
