ricklon/cam-rotation-starter/drives/mg90s/cad/stl/Adapter_075_Sleeved.stl

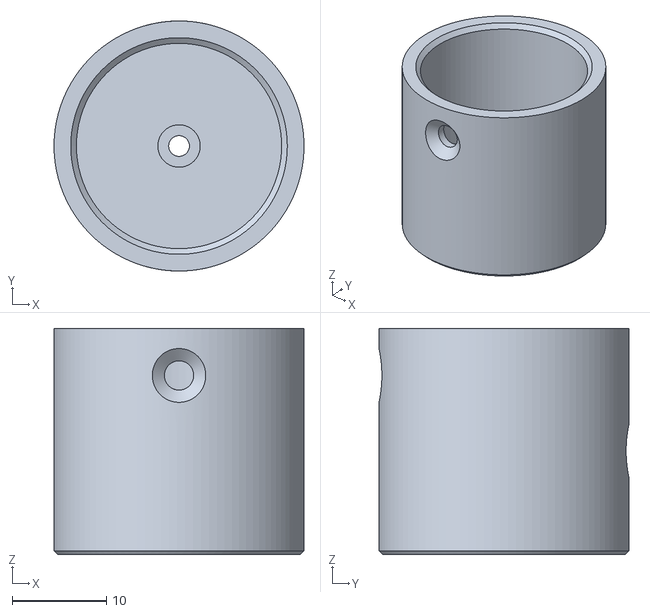
[picture p33: CAD file, 2026-10-24]
drives/mg90s/cad/stl/Adapter_075_Sleeved.stl
26.5 x 26.5 x 24.0
