ricklon/cam-rotation-starter/drives/n20/cad/solidcraft/pipeline/v22/fusion_ref/Control_Pod.step

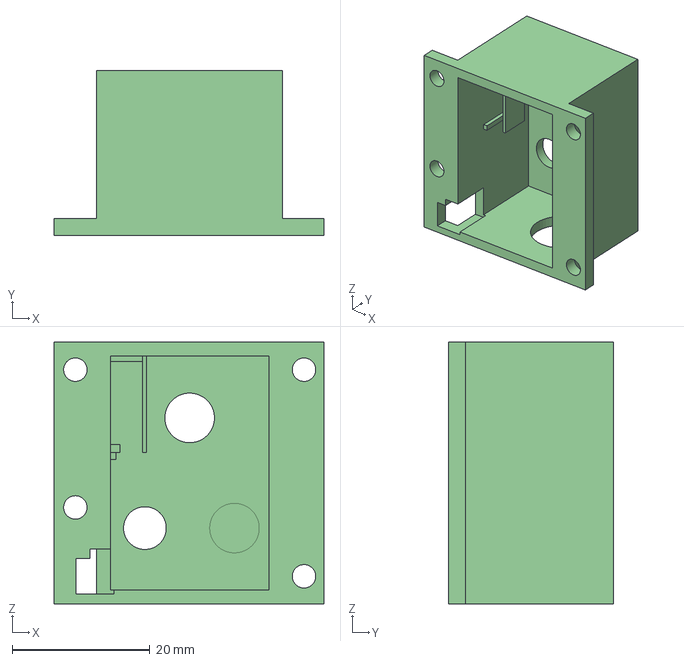
[picture p34: CAD file, 2026-10-29]
drives/n20/cad/solidcraft/pipeline/v22/fusion_ref/Control_Pod.step
39.2 x 24.0 x 38.0 mm
