ricklon/cam-rotation-starter/drives/n20/cad/stl/N20_Control_Pod.stl

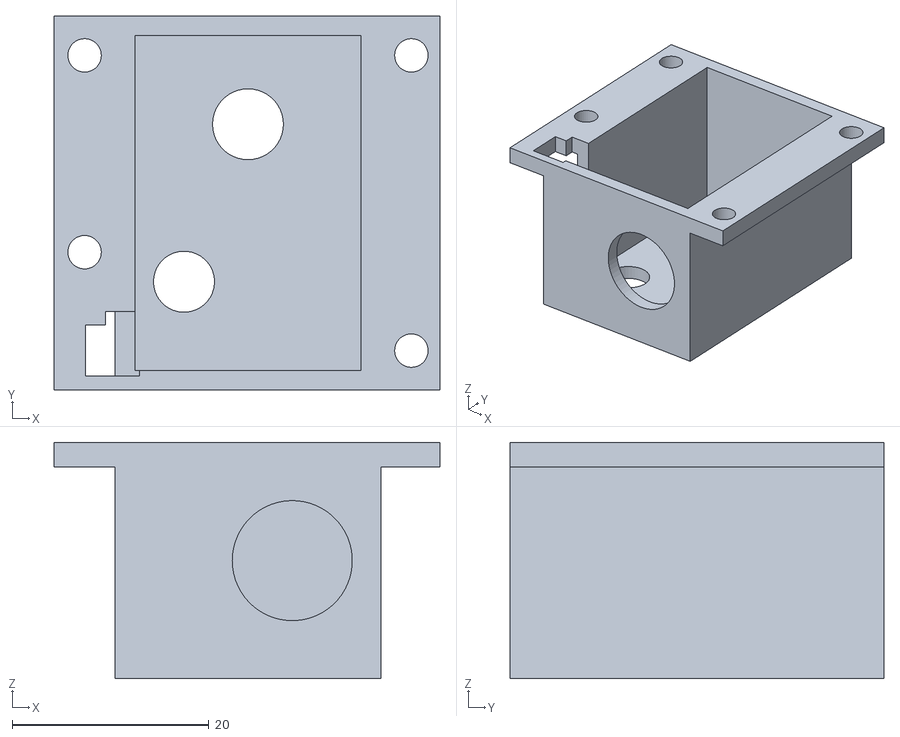
[picture p35: CAD file, 2026-11-03]
drives/n20/cad/stl/N20_Control_Pod.stl
39.2 x 38.0 x 24.0
