ricklon/cam-rotation-starter/drives/mg90s/cad/stl/Dowel_Gauge_0625.stl

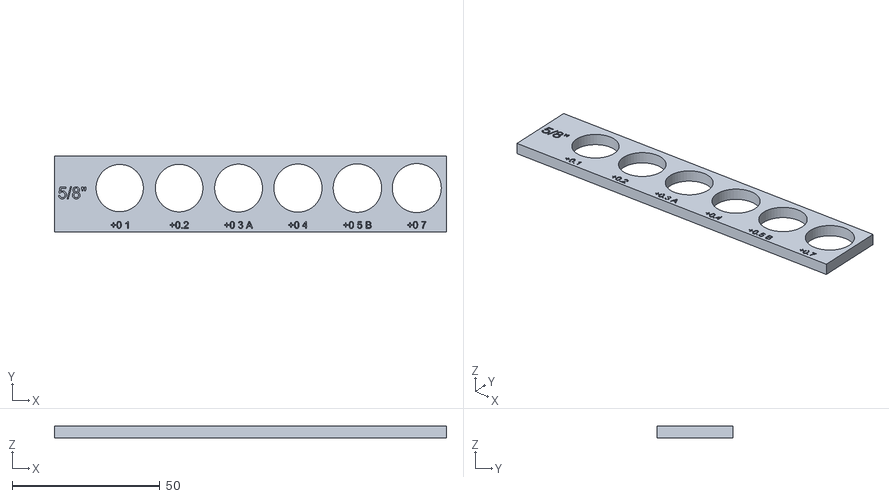
[picture p36: CAD file, 2026-10-22]
drives/mg90s/cad/stl/Dowel_Gauge_0625.stl
132.4 x 25.6 x 4.00
