ricklon/cam-rotation-starter/drives/n20/cad/stl/N20_Mount_Fit_Coupon_Base.stl

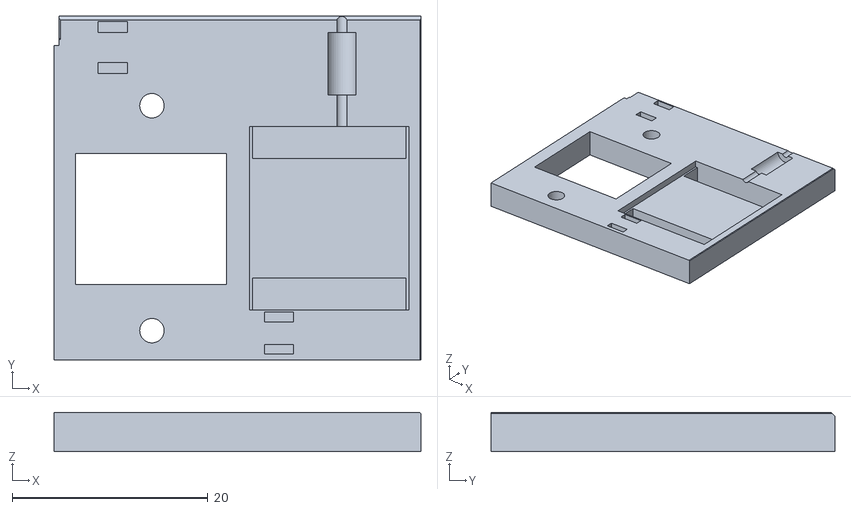
[picture p37: CAD file, 2026-10-29]
drives/n20/cad/stl/N20_Mount_Fit_Coupon_Base.stl
37.5 x 35.2 x 4.00
