ricklon/cam-rotation-starter/drives/mg90s/cad/stl/Dowel_Gauge_075.stl

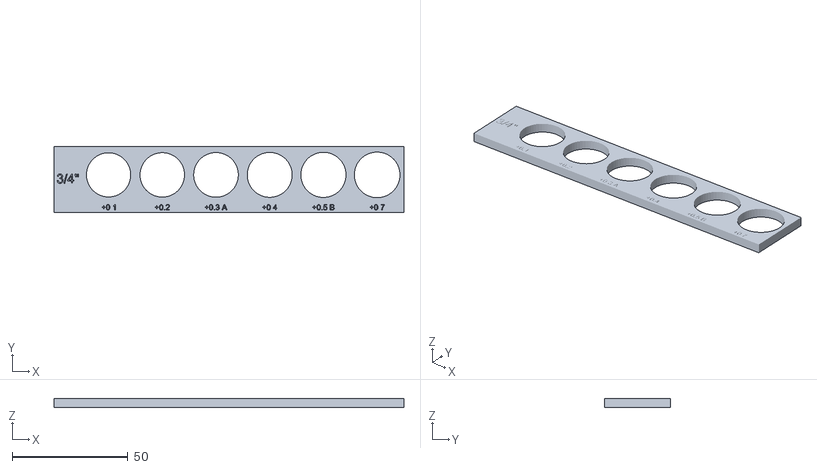
[picture p38: CAD file, 2026-10-22]
drives/mg90s/cad/stl/Dowel_Gauge_075.stl
151.5 x 28.8 x 4.00
