ricklon/cam-rotation-starter/drives/n20/cad/stl/N20_Socket_Coupon.stl

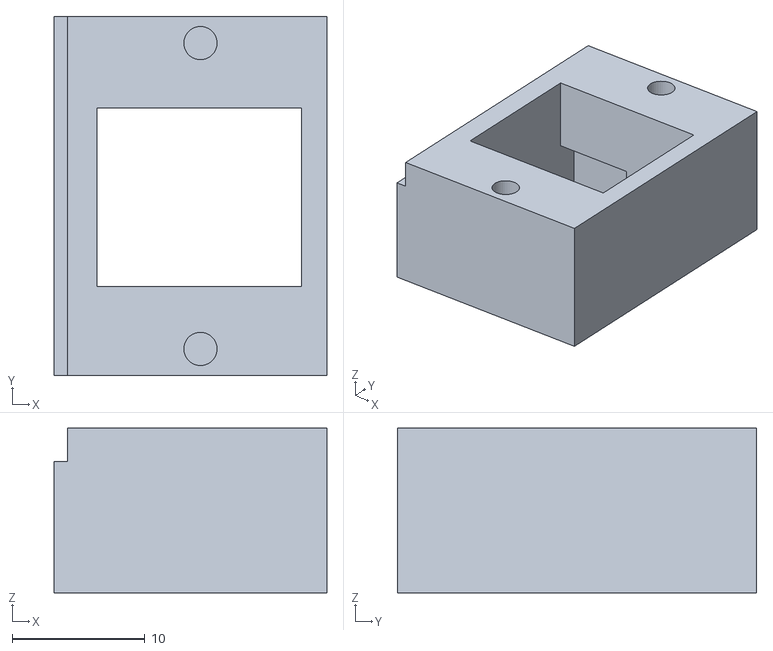
[picture p39: CAD file, 2026-10-29]
drives/n20/cad/stl/N20_Socket_Coupon.stl
20.5 x 27.0 x 12.4
