ricklon/cam-rotation-starter/drives/mg90s/cad/stl/Dowel_Gauge_025.stl

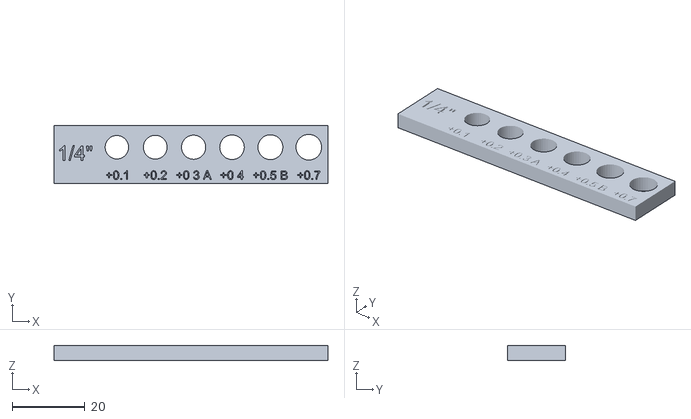
[picture p40: CAD file, 2026-10-22]
drives/mg90s/cad/stl/Dowel_Gauge_025.stl
75.3 x 16.1 x 4.00
