ricklon/cam-rotation-starter/drives/mg90s/cad/stl/Panel_Fit_Coupon.stl

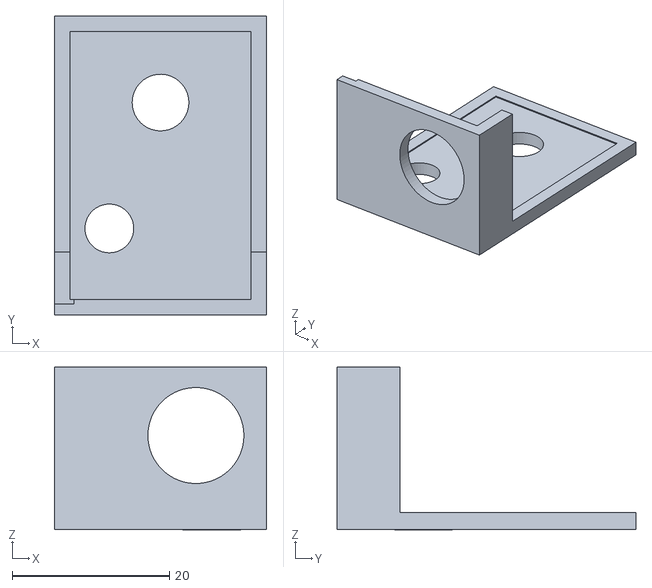
[picture p41: CAD file, 2026-10-22]
drives/mg90s/cad/stl/Panel_Fit_Coupon.stl
27.0 x 38.0 x 20.7
