ricklon/cam-rotation-starter/drives/n20/cad/stl/N20_Adapter_Clamp_0625.stl

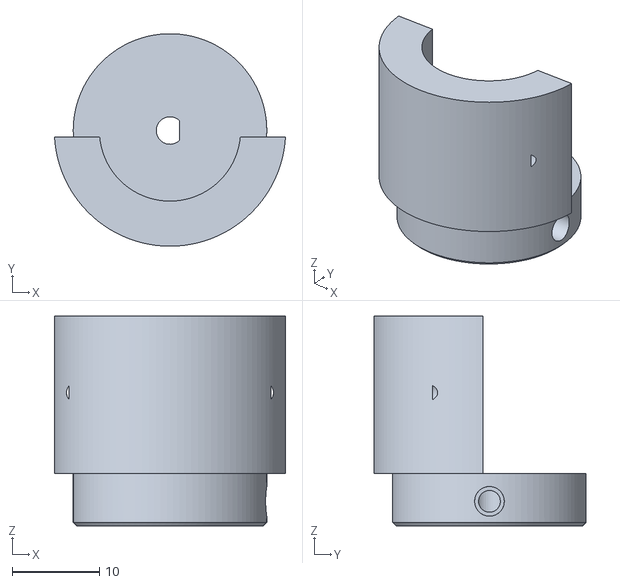
[picture p42: CAD file, 2026-10-27]
drives/n20/cad/stl/N20_Adapter_Clamp_0625.stl
26.5 x 24.3 x 24.0
