ricklon/cam-rotation-starter/drives/mg90s/cad/stl/Adapter_0625.stl

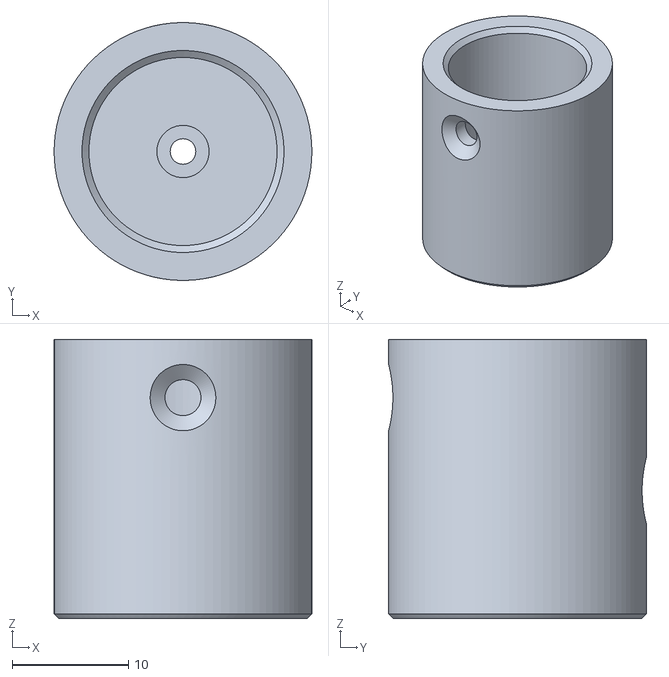
[picture p43: CAD file, 2026-10-22]
drives/mg90s/cad/stl/Adapter_0625.stl
22.2 x 22.2 x 24.0
