ricklon/cam-rotation-starter/drives/mg90s/cad/stl/Fit_Test_Coupon.stl

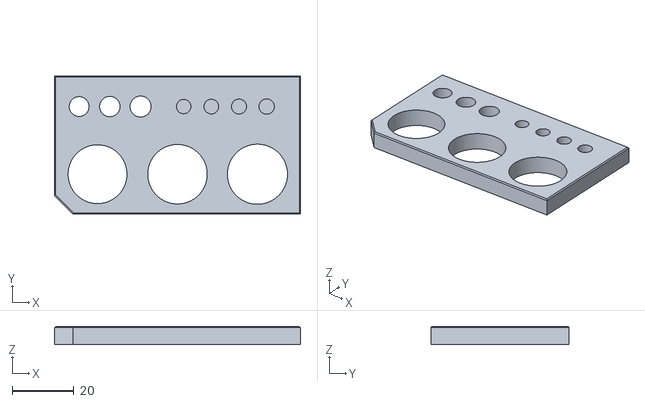
[picture p44: CAD file, 2026-10-22]
drives/mg90s/cad/stl/Fit_Test_Coupon.stl
80.0 x 45.0 x 6.00
