ricklon/cam-rotation-starter/drives/mg90s/cad/stl/Shim_075_for_18p5mm.stl

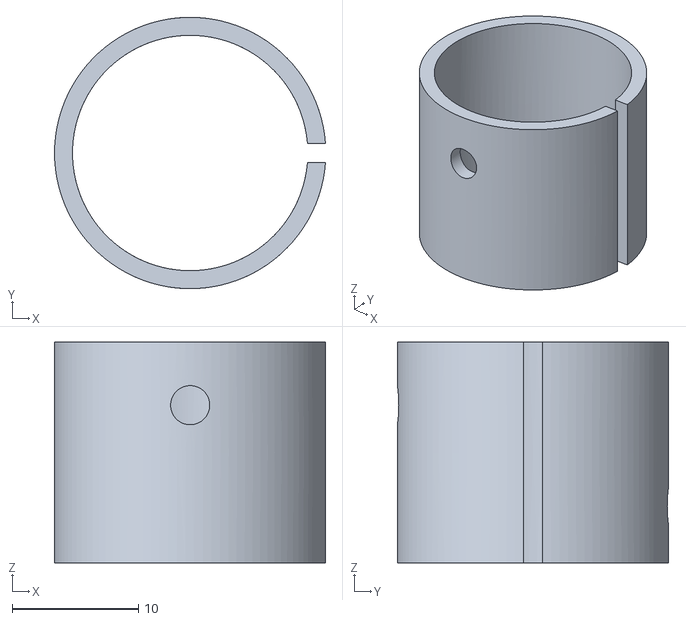
[picture p45: CAD file, 2026-10-22]
drives/mg90s/cad/stl/Shim_075_for_18p5mm.stl
21.5 x 21.5 x 17.5
