ricklon/cam-rotation-starter/drives/n20/cad/stl/N20_Clamp_025_cap.stl

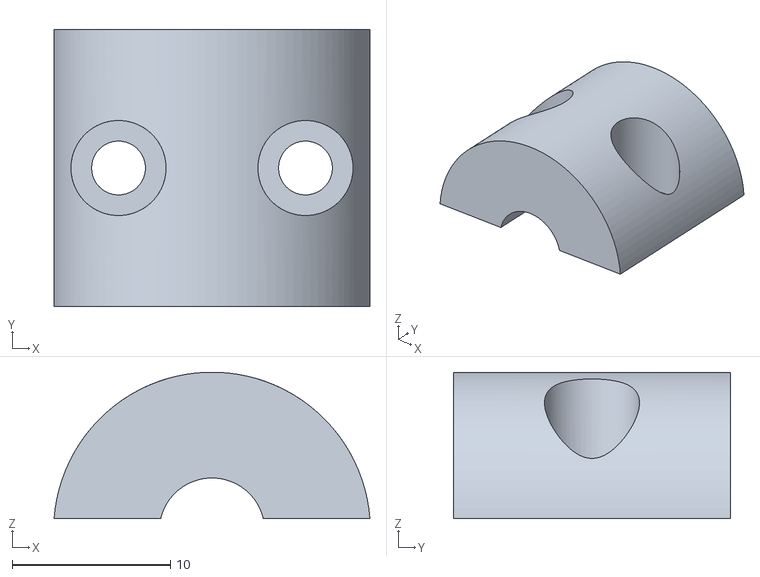
[picture p46: CAD file, 2026-10-27]
drives/n20/cad/stl/N20_Clamp_025_cap.stl
19.9 x 17.5 x 9.24
