ricklon/cam-rotation-starter/drives/mg90s/cad/stl/Adapter_025.stl

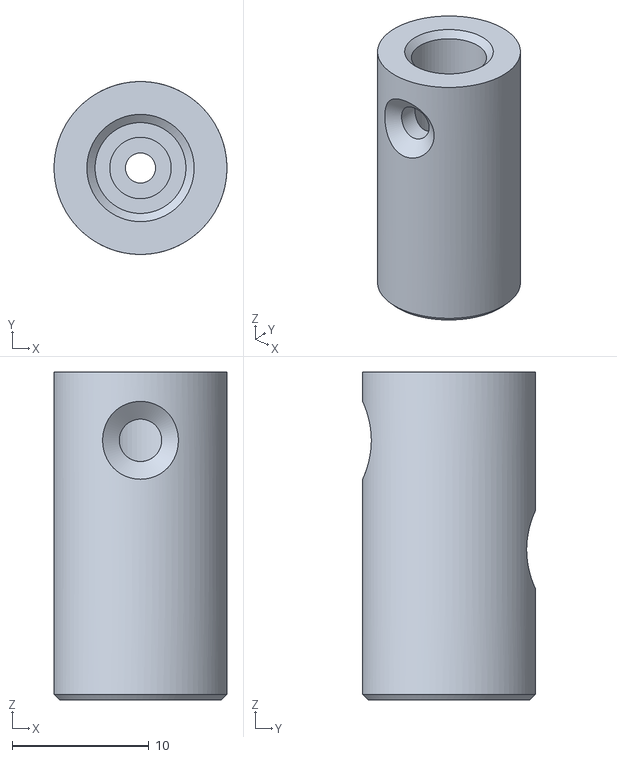
[picture p47: CAD file, 2026-10-22]
drives/mg90s/cad/stl/Adapter_025.stl
12.6 x 12.6 x 24.0
