ricklon/cam-rotation-starter/drives/n20/cad/stl/N20_PETG_Fit_Coupon.stl

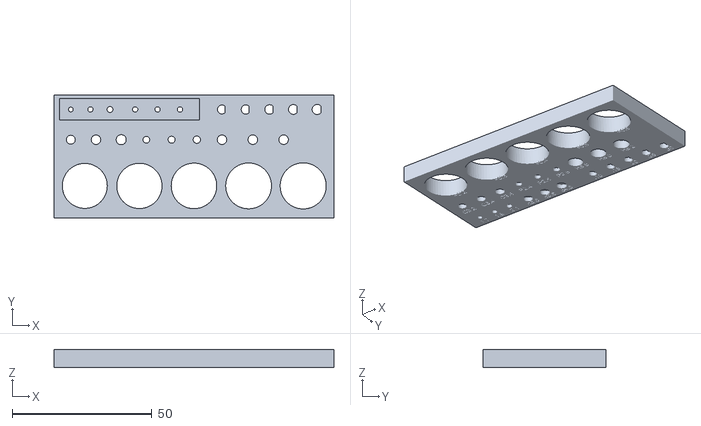
[picture p48: CAD file, 2026-10-27]
drives/n20/cad/stl/N20_PETG_Fit_Coupon.stl
100.0 x 44.0 x 6.50
