ricklon/cam-rotation-starter/(list of files, cad)

Other CAD files:
drives/n20/cad/stl/N20_Bushing_0625.stl
drives/n20/cad/stl/N20_Bushing_075.stl
drives/n20/cad/stl/N20_Bushing_025.stl
drives/n20/cad/stl/N20_Latch_Key.stl
drives/mg90s/cad/stl/Control_Pod.stl
drives/n20/cad/stl/N20_Adapter_075_Sleeved.stl
drives/n20/cad/stl/N20_Adapter_025.stl
drives/n20/cad/stl/N20_Adapter_075.stl
drives/mg90s/cad/stl/Adapter_075.stl
drives/n20/cad/stl/N20_Adapter_Clamp_025.stl
drives/n20/cad/stl/N20_Adapter_0625.stl
drives/mg90s/cad/stl/Shim_075_for_17p5mm.stl
drives/n20/cad/stl/N20_Clamp_0625_cap.stl
drives/mg90s/cad/stl/Shim_075_for_18p0mm.stl
drives/mg90s/cad/stl/Shim_075_for_19p0mm.stl
drives/mg90s/cad/step/cam-rotation-starter.f3d
drives/n20/cad/solidcraft/pipeline/v22/purchased/Bushing_075_1.step
drives/n20/cad/solidcraft/pipeline/v22/purchased/C1_470uF_10V_1.step
drives/n20/cad/solidcraft/pipeline/v22/purchased/D1_1N5817_1.step
drives/n20/cad/solidcraft/pipeline/v22/purchased/HW_Anchor_Zip_Ties_1.step
drives/n20/cad/solidcraft/pipeline/v22/purchased/HW_Arm_Zip_Tie_1.step
drives/n20/cad/solidcraft/pipeline/v22/purchased/J3_JST_PH6_1.step
drives/n20/cad/solidcraft/pipeline/v22/purchased/M3_x_8_Wafer_Head_Screw_1.step
drives/n20/cad/solidcraft/pipeline/v22/purchased/M3_x_8_Wafer_Head_Screw_2.step
drives/n20/cad/solidcraft/pipeline/v22/purchased/M3_x_8_Wafer_Head_Screw_3.step
drives/n20/cad/solidcraft/pipeline/v22/purchased/M3_x_8_Wafer_Head_Screw_4.step
drives/n20/cad/solidcraft/pipeline/v22/purchased/N20_DC_MOTOR_1.step
drives/n20/cad/solidcraft/pipeline/v22/purchased/PETG_Fit_Coupon_1.step
drives/n20/cad/solidcraft/pipeline/v22/purchased/RV1_Speed_Pot_1.step
drives/n20/cad/solidcraft/pipeline/v22/purchased/S1_12mm_Button_1.step
drives/n20/cad/solidcraft/pipeline/v22/purchased/SW1_Dir_Switch_1.step
drives/n20/cad/solidcraft/pipeline/v22/purchased/U3_DRV8833_1.step
drives/n20/cad/solidcraft/pipeline/v22/purchased/Wiring_1.step
drives/n20/cad/solidcraft/pipeline/v22/purchased/XIAO-ESP32S3_v2_1.step
drives/n20/cad/solidcraft/pipeline/v22/purchased/_4_x_3_8_Flat_Head_Wood_Screw__McMaster_90031A108__3.step
drives/n20/cad/solidcraft/pipeline/v22/purchased/_4_x_3_8_Flat_Head_Wood_Screw__McMaster_90031A108__4.step
drives/n20/cad/solidcraft/pipeline/v22/purchased/usbc_pd_w_switches_1.step
drives/n20/cad/step/cam-rotation-n20.f3d
hardware/step/90485A442_M3x10_Flat_Head_Thread_Forming.step
hardware/step/92114A106_Brass_Flat_Head_Wood_Screw_4x1-4.step
hardware/step/98026A029_Steel_Washer.step
hardware/step/98685A950_Brass_Rounded_Head_Wood_Screw_14x3-4.step
