ricklon/cam-rotation-starter/drives/mg90s/cad/stl/print_orientation_preview.png

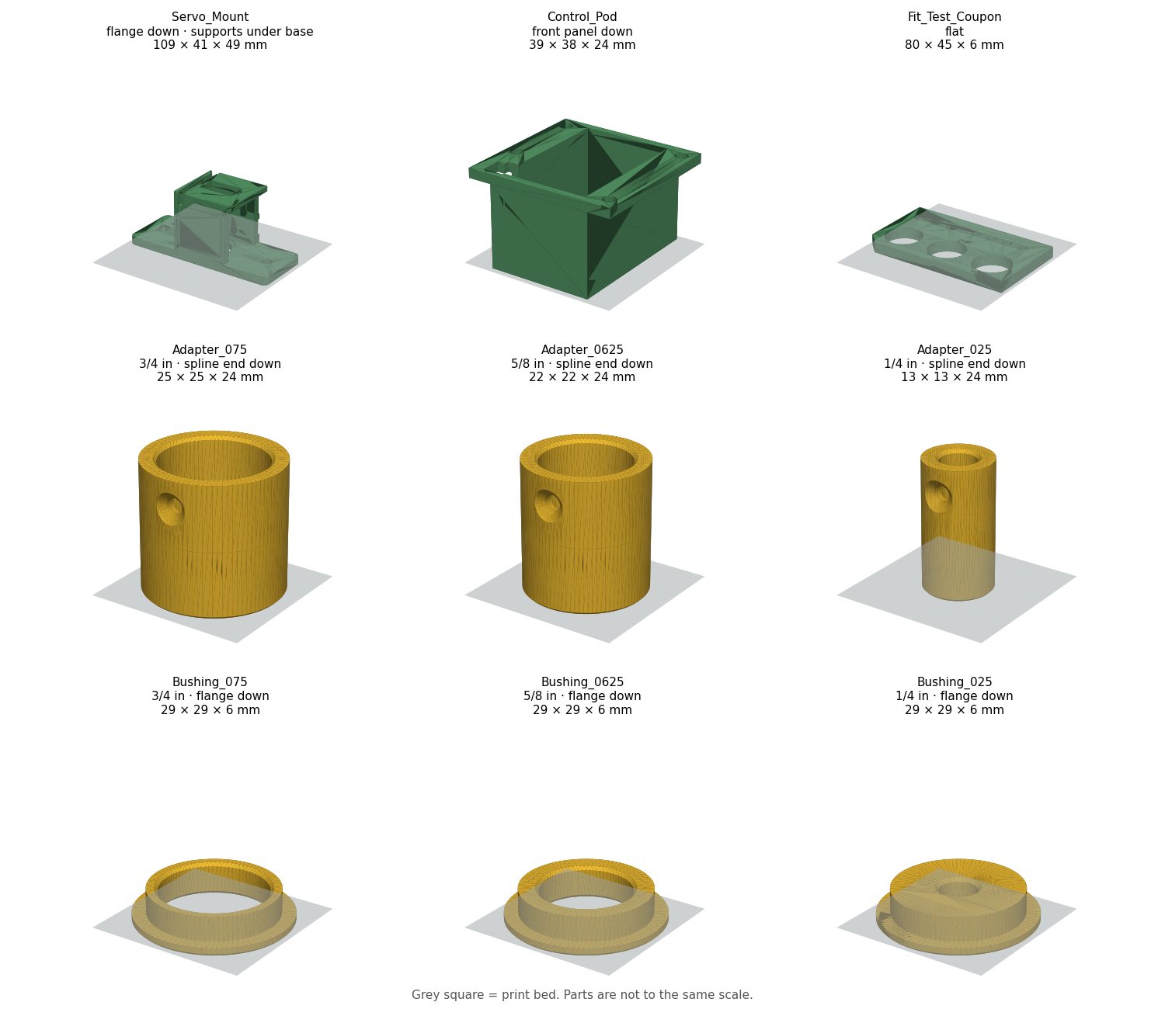
drives/mg90s/cad/stl/print_orientation_preview.png
