ricklon/cam-rotation-starter/drives/n20/docs/images/wiring_electronics.png

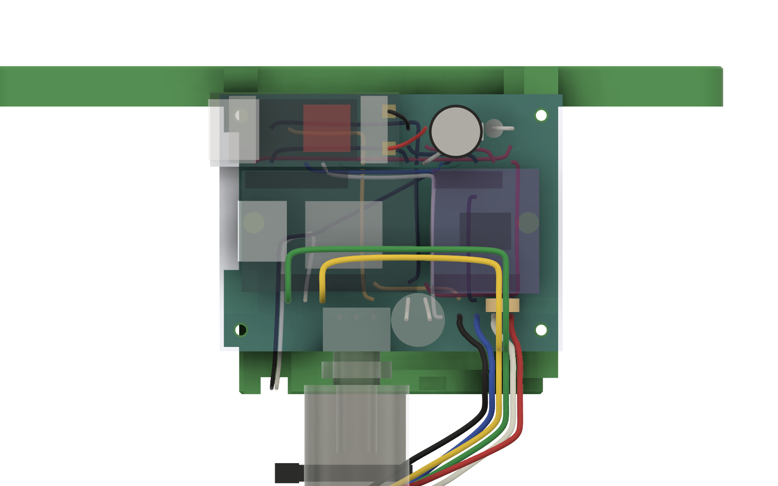
drives/n20/docs/images/wiring_electronics.png
