ricklon/cam-rotation-starter/(commit log)

2026-10-22 Cam Rotation Starter: first public release of design, firmware and docs
    - cad/: Fusion design as STEP and .f3d, print-ready STLs (3/4, 5/8 and 1/4 in
    dowel sets, split clamps and shims for sanded dowels), design scripts
    - firmware/: ESP-IDF firmware for the XIAO ESP32-C6 and the Vite web app
    (live control, story editor with record-by-performing, gallery mode)
    - docs/: parts list and BOM, wiring with schematic and cut list, assembly guide
    - hardware/: fastener list with McMaster part numbers and STEP models
    - classroom/: how stories work, example stories, teaching notes
    - Licenses: CERN-OHL-P-2.0 for hardware and docs, Apache-2.0 for firmware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
    [92114A106_Brass_Flat_Head_Wood_Screw_4x1-4.step, 98026A029_Steel_Washer.step, 98685A950_Brass_Rounded_Head_Wood_Screw_14x3-4.step, Adapter_025.stl, Adapter_0625.stl, Adapter_075.stl, Adapter_075_Sleeved.stl, Adapter_Clamp_025.stl]
2026-10-22 Add issue templates for print-fit reports and build problems
    Claude-Session: https://claude.ai/code/session_01GpjEXhgSr9i81TFkHYveKS
2026-10-22 Show the 12 mm button as polished stainless in the pod render
    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
2026-10-22 Add panel fit coupon to test the controls before printing the pod
    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
    [Panel_Fit_Coupon.stl]
2026-10-22 Seat the capacitor and diode in the mount; add dowel fit gauges
    Servo_Mount gets a 3 mm curved seat for C1 and a channel for D1 and its
    leads in the electronics-side wall. C1, D1 and wires L1-L3, W3 moved to
    match. Dowel_Gauge strips test socket (A) and bushing (B) clearances.
    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
    [Dowel_Gauge_025.stl, Dowel_Gauge_0625.stl, Dowel_Gauge_075.stl, Servo_Mount.stl, cam-rotation-starter.f3d, cam-rotation-starter.step]
2026-10-22 Move the diode inside the mount wall; press-fit seat for the capacitor
    D1 now lies in a channel on the inner face of the electronics-side wall
    with its leads through two 1 mm holes; C1 snaps into a deeper 8.0 mm
    seat with a lead relief below it. L1-L3 and W3 re-routed, through-wall
    diode leads modeled, docs updated.
    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
    [Servo_Mount.stl, cam-rotation-starter.f3d, cam-rotation-starter.step]
2026-10-22 Bring docs up to date with the C1/D1 seats and link the schematic
    - Schematic rev C: S1 labelled as the 12 mm stainless pre-wired button
    - Schematic linked from README, parts, wiring and assembly
    - Assembly, wiring, parts and BOM describe the diode inside the wall and
    the 8 mm press-fit capacitor; new c1_d1_seats close-up
    - Re-rendered xray, exploded, wiring and step images from the current
    model (12 mm button, McMaster hardware); photo.py now handles
    components with several occurrences
    - Cut lengths for L1-L3 updated to the new routes
    - Quick start lists the panel coupon and dowel gauges
    Claude-Session: https://claude.ai/code/se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
    [bom.csv, cut-list.csv]
2026-10-24 Export the M3 thread-forming clamps; update the clamp screw in the docs
    The clamp STLs were still the M2.5 button-head version. Re-export them
    from Fusion v48: 3.4 mm cap holes with 90 deg countersinks for the
    M3 x 10 flat head thread-forming screw (McMaster 90485A442), 2.5 mm
    pilots in the fixed half. Fresh .step and .f3d from the same version.
    orient_stl.py keeps the caps split face down: with the larger holes the
    5/8 cap's end face had slightly more bed contact and won.
    [Adapter_075_Sleeved.stl, Adapter_Clamp_025.stl, Adapter_Clamp_0625.stl, Clamp_025_cap.stl, Clamp_0625_cap.stl, bom.csv, cam-rotation-starter.f3d, cam-rotation-starter.step]
2026-10-24 Split the repo into per-drive folders; start the N20 drive
    - cad/ and docs/ move to drives/mg90s/ unchanged, so the scripts and
    relative links inside them keep working; render scripts gain CAM_DRIVE
    - Top README becomes a drive chooser; drives/mg90s/README.md holds the
    MG90S start-here table and quick start
    - drives/n20/README.md: 6 V N20 + DRV8833 parts, wiring and firmware plan
    - AGENTS.md documents the layout and the vMAJOR.MINOR-<drive> tags
    - v1.0-mg90s tags the last single-drive commit (Fusion version 47)
    Claude-Session: https://claude.ai/code/session_012ujNw6zV2yR5WixYUdRfXo
    [Adapter_025.stl, Adapter_0625.stl, Adapter_075.stl, Adapter_075_Sleeved.stl, Adapter_Clamp_025.stl, Adapter_Clamp_0625.stl, Bushing_025.stl, Bushing_0625.stl]
2026-10-24 Drive the N20 from the firmware; record the N20 decisions
    - Drive type choice (menuconfig → CamBox, or sdkconfig.n20) builds
    motor_drv8833.c in place of servo.c; both implement servo.h
    - motor_drv8833.c: IN1/IN2 on two 20 kHz LEDC channels, slow decay
    (brakes between pulses and at zero), EEP/nSLEEP low until running
    and again after idle_release_ms
    - /api/status reports drive and duty; the web app hides the stop trim
    and µs range on an N20 box
    - drives/n20: the 12-pin DRV8833 module's pinout (J1 open), 100:1
    gear ratio, direct drive on the dowel axis
    Both drive types build with ESP-IDF v5.3.2, no warnings in main/.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
2026-10-24 N20: record the DRV8833 module's 18.5 x 16 mm outline
2026-10-24 N20 mount, D-bore adapters and fit coupon
    From the Fusion design Cam Rotation N20 (version 2):
    - N20 on the dowel axis, gearbox face at z 0 under a 2 mm face plate
    (M1.6 x 4 screws from above), in a sleeve down to the base; the servo
    is hidden, the adapters keep their height
    - Adapters: 3 mm D-bore through the base (n20_bore_clear) in place of
    the spline pocket; horn screw hole and counterbore suppressed
    - DRV8833 module in a 1 mm locating pocket under the base, held with
    foam tape; leftover servo cutout filled behind it
    - N20_Fit_Coupon: gearbox sleeve with both common face-hole patterns,
    D-bores at 0.10/0.15/0.25 mm, and the DRV8833 pocket
    - drives/n20/cad: oriented STLs, STEP/F3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
    [N20_Adapter_025.stl, N20_Adapter_0625.stl, N20_Adapter_075.stl, N20_Adapter_075_Sleeved.stl, N20_Adapter_Clamp_025.stl, N20_Adapter_Clamp_0625.stl, N20_Fit_Coupon.stl, N20_Mount.stl]
2026-10-24 N20 wiring: wire list, schematic, cut list and 3D routes
    - drives/n20/docs/wiring.md: connections, DRV8833 pin rows, W1-W15
    point-to-point list, terminal check, cut list, bring-up
    - schematic.svg rev A: DRV8833 on the 5 V rail, D0/D5/D8 to
    IN1/IN2/EEP, N20 with C2 across it; R1 and the servo gone
    - cad/fusion/wires.py: rebuilds the Wiring component in Cam Rotation
    N20 (Fusion version 4); new wires checked clear of every part and
    each other except at their solder ends
    - wiring_under_base.png rendered from the model
    [cam-rotation-n20.f3d, cam-rotation-n20.step, cut-list.csv]
2026-10-24 N20 fit coupon: holes through, diagonal pair mirrored; add clamp caps
    - The 1.2 mm web was joined after the holes were cut and closed the
    bottom of the shaft hole, the screw holes and the D-bores. Rebuilt
    with all solids first, then every cut.
    - The motor sits face down in the coupon, so the model's diagonal hole
    pair lands at (+x,-y)/(-x,+y). Checked with the N20 model placed in
    the coupon: no overlap, holes coincide.
    - N20 STL set now includes the clamp caps (3.4 mm countersunk holes for
    the M3 thread-forming screws).
    - hardware/step: McMaster 90485A442 STEP exported from Fusion.
    [90485A442_M3x10_Flat_Head_Thread_Forming.step, N20_Clamp_025_cap.stl, N20_Clamp_0625_cap.stl, N20_Fit_Coupon.stl, cam-rotation-n20.f3d, cam-rotation-n20.step]
2026-10-24 N20 print notes: clamp caps included, coupon motor section; link the M3 screw STEP
2026-10-24 5/8 clamp: keep the M3 screw heads clear of the mount walls
    The 5/8 clamp's M3 heads reached 13.58 mm from the axis when tight
    (rule: 13.5) and hit the side walls (14.675 mm) once backed out
    about 3 mm.
    - Both drives: 5/8 cap countersinks 1 mm deeper (clamp_head_y_mid
    2.8 mm), clamp pilots 7.5 mm deep for the longer reach; heads now
    13.42 mm when tight, about 4 mm of back-out before the wall.
    Cam Rotation Starter v49, Cam Rotation N20 v5.
    - N20 mount: 0.6 mm relief in both inner wall faces at z 15-24 mm
    where the heads pass, about 5 mm of back-out; 1 mm of wall left in
    front of the PD zip-tie tunnel.
    - Docs: tighten until the heads are below the cap before turning the
    shaft; cor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
    [Adapter_Clamp_025.stl, Adapter_Clamp_0625.stl, Clamp_0625_cap.stl, N20_Adapter_Clamp_025.stl, N20_Adapter_Clamp_0625.stl, N20_Clamp_0625_cap.stl, N20_Mount.stl, cam-rotation-n20.f3d]
2026-10-24 Print guides: N20 test-print sequence; note the 5/8 clamp reprint
2026-10-25 N20 mount: inline screw holes, solder relief, PD board on a pad
    From the first printed mount:
    - Gearbox screw holes are the inline pair (±4.5, 0), 9 mm apart. The
    n20_hole_x/y parameters now actually drive them.
    - 2.5 mm relief (solder_relief_d) under the XIAO's and the DRV8833's
    pin rows for wire ends and solder.
    - The USB-C PD board sits on a 3.5 mm pad (pd_relief_d) outside the
    electronics-side wall, with 3.5 mm under the whole board for its
    bottom-side parts. Zip-tie tunnel and slots unchanged.
    - PD-board wires (W1, W2, W4, L1-L3) rerouted; W2 and L2 cut 5 mm
    longer.
    Matches Fusion "Cam Rotation N20" version 7.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
    [N20_Mount.stl, cam-rotation-n20.f3d, cam-rotation-n20.step, cut-list.csv]
2026-10-26 N20 change request: C1 8x13 seat, diode under the base, cartridge motor mount, cap-head clamps, JST panel connector, PETG coupon
    Fusion: Cam Rotation N20 version 9.
    1. C1 seat 14 mm tall (c1_seat_h) for the 8 x 13 mm can, 8.0 mm press fit,
    1.6 mm lower so the control wires clear its top.
    2. D1 out of the wall into a channel under the base between the XIAO 5V
    pad and the DRV8833 VCC pin; its own leads replace L3 and W3.
    3. Driver signals on the XIAO bottom row (D10/D9/D8) to the DRV8833's
    channel B (IN3/IN4, OUT3/OUT4) directly below; power in two lanes
    under the -Y wall. Firmware pins: AIN1=GPIO18 (D10), AIN2=GPIO20 (D9).
    wires.py, wiring.md, cut list and schematic (rev B) upd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
    [N20_Adapter_Clamp_025.stl, N20_Adapter_Clamp_0625.stl, N20_Cartridge.stl, N20_Clamp_025_cap.stl, N20_Clamp_0625_cap.stl, N20_Control_Pod.stl, N20_Fit_Coupon.stl, N20_Mount.stl]
2026-10-26 N20: STEP/F3D snapshot from Fusion version 10 (cartridge M1.6 holes linked to n20_hole_x/y)
    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
    [cam-rotation-n20.f3d, cam-rotation-n20.step]
2026-10-26 N20 mount fit coupon: pieces of the real mount and pod
    N20_Mount_Fit_Coupon checks the fits the PETG coupon doesn't, before
    the long prints: capacitor seat, XIAO pocket and solder relief, PD seat
    and ledge, DRV8833 pocket and relief, diode channel and lead slot,
    cartridge socket and M3 pilots, tie slots and anchors A1/A2, and the
    pod's JST holder.
    In Fusion the pieces are boxes intersected with the mount and pod
    (tool bodies kept), so they follow later changes. They print the way
    the full parts do: mount piece wall-top down, pod piece front panel
    down. About 16 g. Print guide step 3.
    Matches Fusion "Cam Rotation N20" version 11.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
    [N20_Mount_Fit_Coupon.stl, cam-rotation-n20.f3d, cam-rotation-n20.step]
2026-10-26 N20 mount fit coupon: three flat-based pieces; pod needs supports
    The single-file coupon had a floating cantilever (Bambu Studio warns,
    and lay flat left pieces in the air). It is now three files, each
    already the way up its full part prints:
    - _Wall: electronics wall, wall top down (as the mount). No supports.
    - _Base: 4 mm base plate, inside face down, underside up. No supports.
    - _Pod: pod corner with the JST holder, front panel down.
    Sliced on a Bambu A1 in PETG at 0.2 mm: wall and base clean without
    supports; the pod piece and N20_Control_Pod itself need tree supports
    allowed on the model (the JST holder starts in mid-air above the
    front panel). The print guide said the pod needs none;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
    [N20_Mount_Fit_Coupon.stl, N20_Mount_Fit_Coupon_Base.stl, N20_Mount_Fit_Coupon_Pod.stl, N20_Mount_Fit_Coupon_Wall.stl, cam-rotation-n20.f3d, cam-rotation-n20.step]
2026-10-27 N20 mount: fill the slot between the base and the N20 plate
    Build-plate supports got trapped in the open slot under the base (model
    z -6.4 to 0). It's now solid, before the cartridge socket and pilot cuts,
    which still cut through it. Sliced on an A1 in PETG: no support left in
    the slot, about 2 h 48 min instead of 3 h 1 min, +6.6 g.
    Fusion Cam Rotation N20 version 13.
    [N20_Mount.stl, N20_Mount_Fit_Coupon_Base.stl, N20_Mount_Fit_Coupon_Wall.stl, cam-rotation-n20.f3d, cam-rotation-n20.step]
2026-10-27 N20: snap-fit motor and cartridge, no screws
    The motor snaps into the cartridge: two 1.5 mm arms down its flats hook
    0.8 mm over the back of the end cap, n20_len (25.1 mm) below the gearbox
    face. The cartridge snaps into the mount: a 1.2 mm tongue in each side
    wall carries a 1 mm bump into a pocket in the socket; it goes in empty,
    and the gearbox then stops the tongues flexing. The cartridge prints on
    its side so arms and tongues bend along their layers. The M1.6 and M3
    holes stay as a fallback.
    W14/W15 rerouted down the motor's open side between the arms (cut
    lengths unchanged). New N20_Socket_Coupon (mount round the socket) to
    test the latch. Cartridge and coupon slice clean on an A1 in P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
    [N20_Cartridge.stl, N20_Mount.stl, N20_Socket_Coupon.stl, cam-rotation-n20.f3d, cam-rotation-n20.step, cut-list.csv]
2026-10-27 N20 adapters: M3 set screw onto the motor shaft's D flat
    All six adapters and clamps get an M3 x 5 set screw at right angles to
    the D flat, 2.8 mm above the D-bore end (the shaft goes 5.1 mm in): a
    clamp_pilot (2.5 mm) hole from the bore out to 5.6 mm radius, then a
    clamp_clear (3.4 mm) access hole. Tightened with a 1.5 mm hex key
    through an open end of the mount once the motor is in. All six slice
    clean on an A1 in PETG at 0.16 mm. Fusion Cam Rotation N20 version 15.
    [N20_Adapter_025.stl, N20_Adapter_0625.stl, N20_Adapter_075.stl, N20_Adapter_075_Sleeved.stl, N20_Adapter_Clamp_025.stl, N20_Adapter_Clamp_0625.stl, cam-rotation-n20.f3d, cam-rotation-n20.step]
2026-10-27 N20 snap fit: tighter hooks and latch, zip-tie lock on the motor arms
    The first snap fit let go under almost any pressure: the hooks were set
    for the 25.1 mm reference motor but ours measures 24.1 mm, and with the
    motor in the 1 mm, 45 deg latch bumps only overlapped about 0.4 mm.
    - n20_len 24.1 mm (measured); hooks 1.2 mm deep (was 0.8) with a 0.2 mm
    barb so a pull draws the arms in, 1.0 mm lead-in
    - two ribs across each arm seat a 2.5 mm zip tie that stops the arms
    spreading
    - latch bumps 1.4 mm (was 1.0) with a steep (~70 deg) lower face; socket
    pockets deepened to match and their floor raised to cut play to ~0.2 mm
    - the edited features were recreated in place so the socket coupon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
    [N20_Cartridge.stl, N20_Mount.stl, N20_Socket_Coupon.stl, cam-rotation-n20.f3d, cam-rotation-n20.step]
2026-10-27 N20: model the motor arms' zip tie in place
    HW_Arm_Zip_Tie: a 2.5 x 1.0 mm band round the cartridge's motor arms,
    between the tie ribs, head on the -x side; it follows n20_len. W14/W15
    moved inside it (x 6.7, between the tie and the can), so W14 is now cut
    50 mm (was 45). Renders show the tie; the under-base alt text no longer
    says the cartridge is screwed on. No print files changed.
    Fusion Cam Rotation N20 version 17.
    [cam-rotation-n20.f3d, cam-rotation-n20.step, cut-list.csv]
2026-10-27 N20 cartridge latch: square catch, tighter socket, release key
    The version 16 latch still pulled out with the motor in: its bumps' lower
    face sloped about 20 degrees off square, so a hard pull ramped the tongue
    in past the socket wall.
    - Latch bumps keep 1.4 mm and the 45 degree lead-in but get a square
    catch face; the pocket floor sits 0.1 mm below it.
    - cart_clear 0.3 -> 0.2 mm, so each bump sits 1.2 mm past the socket
    wall; with the motor in, 0.8 mm of square catch is left.
    - The pockets become slots open through the top of the base, and the
    new N20_Latch_Key (a printed fork) goes down them to press both
    tongues in and release an empty cartridge.
    - Socket coupon follows the mount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
    [N20_Cartridge.stl, N20_Latch_Key.stl, N20_Mount.stl, N20_Socket_Coupon.stl, cam-rotation-n20.f3d, cam-rotation-n20.step]
2026-10-27 N20: record that the version 18 cartridge latch printed and holds
2026-10-28 N20 mount: slot fill only fills the slot
    The base-plate slot fill (version 13) started at the bottom of the base,
    z -10.4, instead of its top, z -6.4, and ran 1.3 mm into the side walls.
    Being later in the timeline, it filled in the DRV8833 pocket and its
    solder relief, the D1 channel and lead slot, the wire channel under the
    pod-side base and the inner end of one control pod pilot.
    Recreated in place: base top to the N20 plate, between the walls' inner
    faces. Mount, socket coupon and wall/base fit coupons re-exported; the
    mount still slices with no supports in the slot. Under-base and
    electronics images re-rendered. Fusion Cam Rotation N20 version 19.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
    [N20_Mount.stl, N20_Mount_Fit_Coupon_Base.stl, N20_Mount_Fit_Coupon_Wall.stl, N20_Socket_Coupon.stl, cam-rotation-n20.f3d, cam-rotation-n20.step]
2026-10-28 N20: model the zip ties at anchors A1 and A2
    The underside's tie anchors were hard to read, and W14/W15 didn't
    actually pass through A2 in the model.
    - HW_Anchor_Zip_Ties: a 2.5 mm tie through each anchor, up one slot,
    over the bar, down the other and round the wires. No clashes.
    - W14 and W15 rerouted along under the base through A2; routed 35 and
    47 mm, cut 55 and 65 (were 50 and 60). W1/W2 already ran through A1.
    - wiring.md explains what each opening under the base is; the two
    round holes by the socket are the cartridge's M3 pilots, not ties.
    - Under-base and electronics images re-rendered.
    Fusion Cam Rotation N20 version 20. Print files unchanged.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
    [cam-rotation-n20.f3d, cam-rotation-n20.step, cut-list.csv]
2026-10-29 Audit fixes: N20 CAD notes, cut lengths, script docs
    - Add drives/n20/cad/README.md naming the Fusion document and the
    version the step/ snapshots match (20), ready for a v*-n20 tag.
    - AGENTS.md: the N20 drive renders with shots.py, which sets CAM_DRIVE.
    - Cut lengths that broke routed x 1.15 + 10, rounded up to 5 mm:
    MG90S L2 50 -> 55, N20 W1 110 -> 115, N20 W6 160 -> 155.
    - Firmware README: the Play tab drives the motor, not only a servo.
    [cut-list.csv]
2026-10-29 N20: trial rebuild in SolidCraft 0.26.1, with bug repros
    drives/n20/cad/solidcraft holds a rebuild of the N20 drive from Fusion
    Cam Rotation N20 version 22:
    - N20 SolidCraft v22.solidcraft: the cartridge, latch key, adapters,
    clamps and control pod built natively from Fusion's feature history,
    the mount as Fusion's STEP (SolidCraft's booleans fail on it), the
    bought parts as STEP imports, and a hidden Fusion reference with
    the differences coloured.
    - pipeline/: the Fusion extraction scripts, the feature-to-command
    converter with its named workarounds, volume and surface checks, and
    the extracted v22 data and STEP exports.
    - repros/: standalone scripts for the SolidCraft failures,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
    [06_fusion_Adapter_025.step, Adapter_025.step, Adapter_0625.step, Adapter_075.step, Adapter_075_Sleeved.step, Adapter_Clamp_025.step, Adapter_Clamp_0625.step, Bushing_075_1.step]
2026-10-30 Web: virtual button, knob and direction switch on the Play tab
    Adds a Virtual panel card that stands in for the physical panel while it
    isn't fitted. The firmware takes {btn,dir,knob} WebSocket messages and
    injects them as the same control events. The virtual switch is ignored
    while a physical switch is wired. Documented in firmware/README.md.
2026-10-31 Playlists, save-as for stories, and play-along recording
    Playlists: ordered lists of up to 16 stories stored in /data/playlists,
    played once each in order then repeated. New /api/playlists endpoints,
    {"playlist":name} on /api/play, and a Playlists card on the Stories tab.
    Next skips ahead and Stop ends the playlist.
    Story and playlist names are editable in the editor; changing the name
    saves a copy and refuses to overwrite a different existing item.
    Recording can play an existing story as a guide while the slider only
    records the new take.
    The next story now loads into a heap buffer: loading it on the player
    task's stack overflowed it and rebooted the box at the first hand-off.
    Co-Author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
    [player.c, player.h, storage.c, storage.h, web.c]
2026-10-31 Firmware: board choice for the ESP32-C6 Super Mini
    CamBox -> Board in menuconfig (or sdkconfig.supermini) picks the pin map in
    main/board.h. The Super Mini keeps the driver on GPIO18/20/19 and moves the
    panel to GPIO1/2/3/0, clear of strapping, USB and UART pins; it has no RF
    switch, so board_init only drives GPIO3/14 on the XIAO. All four
    board x drive builds pass with no warnings in main/.
2026-10-31 N20 rev C: perfboard electronics, Super Mini, motor wire clamp
    Fusion "Cam Rotation N20" version 24 (version 23 also saved the owner's
    earlier unsaved edits).
    - Motor strain relief: a slotted tie plate below the cartridge's +Y snap
    arm holds W14/W15 about 5 mm from the motor tabs, and the motor unplugs
    at J4 (side-entry JST-PH 2) on the perfboard.
    - ESP32-C6 Super Mini, DRV8833, D1, an RK097N speed pot and J4 on an
    ElectroCookie 1/4 perfboard (docs/perfboard.md, images/perfboard.svg).
    It sits on four 9 mm bosses on an enlarged +X flange ear under the new
    printed N20_Electronics_Cover, held by four M2 x 20 screws; the pot's
    bushing goes through the cover. The rev B pockets stay f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
    [N20_Cartridge.stl, N20_Electronics_Cover.stl, N20_Mount.stl, cam-rotation-n20.f3d, cam-rotation-n20.step, cut-list.csv]
2026-11-01 N20 rev C: PD board on the perfboard, electronics into the mount
    Fusion "Cam Rotation N20" version 25.
    - The USB-C PD board moves onto the perfboard (columns A-C, rows 9-17,
    on 3 mm foam pads, screw terminal removed); W1/W2 become short jumpers
    to the 5V (row 7) and GND (row 8) buses. Both USB-C ports face +X.
    - The perfboard and its cover move from the enlarged flange ear to the
    mount's -Y face: the ear is back to its original size, and the mount
    gets two posts from the flange, two gusseted bosses and a rail past the
    face's +X edge, with M2 pilots. The cover is the mount's outer wall,
    open at +X for the plugs, with a bottom notch for the motor pair; the
    corner under the PD bo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
    [N20_Electronics_Cover.stl, N20_Mount.stl, cam-rotation-n20.f3d, cam-rotation-n20.step, cut-list.csv]
2026-11-02 N20: all wiring 30 AWG stranded, in the colours on hand
    Every wire, including the motor pair, power jumpers and underside links,
    is now 30 AWG stranded (0.6 mm in wires.py). W5, W12, W13 and W21 are
    green, blue, white and yellow. wiring.md adds tinning, flat-link and
    current notes. The motor pair sits flat on the cartridge's wire clamp;
    cut lengths are unchanged. Hole map and wire renders redone.
    [cut-list.csv]
2026-11-02 N20 / Super Mini: knob wiper on GPIO4, low end on GPIO3
    Follows the build's actual wiring: RV1 runs 3V3 -> pot -> GPIO3, with
    its wiper on GPIO4. Its pins now sit at J10-J12, in the 3V3 (via W21),
    GPIO4 and GPIO3 strips, so links W19 and W20 are gone. DIR_FWD moves
    to GPIO2 (W9 to I13); the J3 pinout is unchanged.
    Firmware (Super Mini only): PIN_KNOB GPIO4, PIN_KNOB_GND GPIO3 driven
    low before the first ADC read, DIR_FWD GPIO2, and KNOB_REVERSED so
    clockwise is still faster with 0-100 scaling. GPIO4 is a strapping pin
    (MTMS) but only picks the JTAG source when that eFuse is burned. All
    four drive/board builds pass.
    Model: RV1 and the cover's 7 mm hole move two rows; H11 header pin
    added. C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
    [N20_Electronics_Cover.stl, cam-rotation-n20.f3d, cam-rotation-n20.step, cut-list.csv]
2026-11-02 N20: C3, a 470 uF hold-up capacitor for the Super Mini
    C3 sits after D1 (D1 cathode / Super Mini 5V to GND), so it can only
    discharge into the Super Mini and keeps it running when a motor start
    or stall pulls the 5 V bus down. It lies on its side on the perfboard
    over columns I-J, rows 5-8, its end past the edge inside the cover,
    leads in I7 (+) and I8 (-). New underside links W22 (C2 -> H7) and
    W23 (A16 -> H8) feed those strips.
    wiring.md notes the 940 uF inrush at plug-in: well over USB's 10 uF
    attach limit and untested with this PD board, so bench-test it.
    Model: C3 added to the perfboard; clash check clean. STEP/f3d, hole
    map, schematic (rev C.2), wiring, perfboard, parts, cut list and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
    [cam-rotation-n20.f3d, cam-rotation-n20.step, cut-list.csv]
2026-11-02 N20: motor's factory leads for W14/W15; clamp sized for them
    W14 and W15 are now the N20's own red/black leads (assumed ~26 AWG,
    1.0 mm; unconfirmed), cut to 85/95 mm from the end cap and crimped into
    J4's PHR-2 housing; the factory joints stay. Docs note that red/black
    here aren't the supply colours: the pair only reaches J4.
    The cartridge's wire clamp now has a 2.4 mm bar between its zip-tie
    slots (was 1.4 mm) and a 1 mm longer plate. W15 re-routed so the pair
    lies side by side without crossing; clash check clean apart from the
    leads' own joints. Cartridge STL, STEP/f3d and renders updated.
    [N20_Cartridge.stl, cam-rotation-n20.f3d, cam-rotation-n20.step, cut-list.csv]
2026-11-02 N20: snapshots match Fusion version 27 (C3, factory motor leads)
2026-11-02 N20: step-by-step wiring guide, one picture per wire
    docs/wiring-steps.md takes the rev C perfboard one wire, link or part at a
    time in perfboard.md's build order: ID, colour, cut length, holes, side,
    what it connects and a continuity check. Each step has an SVG sized for a
    phone, the earlier steps in grey and the current one in colour, with its
    holes circled; underside steps show the board turned over.
    images/steps-wiring/make_steps.mjs writes both and checks the IDs, colours
    and cut lengths against cut-list.csv.
2026-11-02 N20 wiring steps: which end of D1 and C3 is which
    Step 1 gets a sketch of the 1N5817 (band = cathode, to A2; plain end =
    anode, to A3), its schematic symbol, and how it stands on the board; the
    step picture labels A2 as the band end. Step 14 gets the same for C3:
    stripe = minus, to I8.
2026-11-02 N20 wiring steps: checks say "connects to" / "must not connect to"
    Replaces "beeps to" / "does not beep to", and adds a line on reading
    the checks: on the continuity setting, connected means it beeps or reads
    near 0 ohms. The diode-test and resistance checks are unchanged.
2026-11-03 N20 wiring steps: the underside print is mirrored
    The ElectroCookie board's underside letters are mirrored (top A2 is
    printed J2 underneath). The underside step pictures now label columns
    and circled ends with the printed underside names, with the
    component-side name smaller; the guide gives both names for underside
    work, and the push-through wires give where they go in underneath.
    perfboard.md explains the mirrored print with a wire test to check a
    board, and both pages get a tip on laying a link flat.
2026-11-03 N20: U1's pads the other way round, W1 and W2 rerouted
    On the owner's PD board the - pad is the outer one (column A side) and
    the + pad the inner one (channel side), the opposite of the drawings.
    W2 now runs from the outer - pad straight to A8, and W1 from the inner +
    pad passes between A8 and B8 to A7, so they don't cross (2.3 mm apart).
    A7 and A8 stay; D7/E7 sit in the ~1 mm gap between the two modules.
    The Fusion pad bodies are renamed to match and the wiring rebuilt
    (clash check clean apart from the board's unmodelled holes and the
    wires' own pads); W2's route is 8 mm, cuts unchanged. Steps 17-19 say to
    go by the + and - printed on the PD board, with a 5 V check across the
    pads before so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
    [cam-rotation-n20.f3d, cam-rotation-n20.step, cut-list.csv]
2026-11-03 N20: C1 stands on the perfboard; its seat, L1 and L2 are gone
    C1 (470 uF, 8 x 13) can't lie flat anywhere on the built board, and rows
    7/8 left have no free GND hole on top, so it stands over columns A-C,
    rows 4-7, between D1 and W1/W2, 1.5 mm off the board: + to C7 (5V bus),
    - to B4 (GND), leads sleeved because they cross the IN3/IN4 pads. No new
    links, and nothing in wiring steps 1-19 changes.
    The cover prints top plate down, so a closed bump over the can would
    print in mid-air; it gets a 9 mm hole instead, and the can's top stands
    about 3.5 mm proud of it. Fusion interference check: C1 clear of the
    cover, both modules, D1, U1 and every wire (0.5 mm radial clearance in
    the hole).
    Removed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
    [N20_Electronics_Cover.stl, N20_Mount.stl, N20_Mount_Fit_Coupon_Wall.stl, cam-rotation-n20.f3d, cam-rotation-n20.step, cut-list.csv]
2026-11-03 N20 wiring steps: through-board wires drawn behind the board, with a side view
    The panel wires (steps 20, 22-24) were drawn as a bold line across the
    component side and off the edge, as if they wrapped round the board.
    Now the top view marks the hole with a dot in a ring (the wire comes up
    through here), draws the run behind the board dashed, and adds a key and
    an edge-on side view: the wire along the gap over the mount, up through
    the hole, soldered on top with the stub trimmed. The 'On the drive'
    section opens with an edge-on orientation picture of the board on the
    mount. Pictures and text only; steps 1-19 and every hole and wire are
    unchanged.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
2026-11-03 N20 wiring steps: a 'Do this' list for every step
    Each step now starts with numbered plain actions right under its
    picture, naming every hole as printed on the side being worked, with the
    other side's name in brackets: underside links start and end at the
    printed underside names, the panel wires run behind the board and come
    up through the printed underside hole to be soldered at the top name,
    parts say which way round, which holes on top, and where to solder
    underneath. Every hole, wire and picture is unchanged.
2026-11-03 N20: no direction switch; the button is wired straight to the board
    SW1 never arrived, so the controls are the knob on the perfboard and the
    12 mm button in the pod. SW1, the J3 panel connector and its holder in
    the pod, W9, W10 and the pod-side wires (W6p, W9p-W11p, J1) are gone.
    W6 (white, button lead A to I14) and W11 (black, lead B to A4) now run
    straight from the button, back through the pod, the base tunnel and up
    the -Y face, in from the underside as before. Routed 165 and 137 mm, cut
    200 and 170 mm from the button; use the button's own leads if they
    reach, otherwise splice in the pod. The pod no longer unplugs.
    Firmware: without the switch both DIR pins read high, which
    controls_dir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
    [N20_Control_Pod.stl, N20_Mount_Fit_Coupon_Pod.stl, cam-rotation-n20.f3d, cam-rotation-n20.step, cut-list.csv]
2026-11-03 N20 docs: bring-up for firmware without a direction-switch input
    The Super Mini build no longer reads a direction switch at all, so the
    bring-up step to untick 'Direction switch is wired' is gone, and the
    wiring notes and the schematic (rev C.5) say the motor always runs
    forward.
2026-11-03 Firmware: boards without a direction switch (Super Mini)
    board.h gets BOARD_HAS_DIR_SWITCH: 1 on the XIAO, 0 on the Super Mini
    (the N20 rev C build has only the knob and the button). When it's 0,
    switch_installed is forced false whatever was saved or posted, GPIO2
    and GPIO0 aren't configured or read, and direction is forward.
    controls_dir() is unchanged, so a virtual direction switch that takes
    over when switch_installed is false still works.
    /api/settings reports has_dir_switch, and the web app hides the
    'Direction switch is wired' checkbox when it's false (one guard, in
    web/src and the data/www copy).
    Built all four configurations (ESP-IDF 5.3.2): 0 warnings in main/.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
2026-11-03 N20 wiring steps: the two button wires together, then C1
    Steps 20-22 are now W11 (button lead B to A4), W6 (button lead A to
    I14), then C1 standing. Both wires still go in before C1, which stands
    over A4. Steps 1-20 are unchanged; 21-24 re-rendered.
2026-11-03 Firmware: serial console for Wi-Fi and diagnostics
    The USB-C port (USB Serial/JTAG) is now the primary console and carries a
    `cambox>` prompt: status, wifi (scan / join / forget), ap, get, set,
    motor, stop, play, log, restart, reset-network. Settings go through
    settings_apply_json() like the web API and are saved at once; network
    changes apply after restart. Passwords are never printed.
    Built all four configurations (ESP-IDF 5.3.2), no warnings in main/.
    Tested on the Super Mini: status, wifi, wifi scan, get and help.
    [app_main.c, console.c]
2026-11-03 N20: bushing bore passes the assembled 5/8 clamp; N20-only bushings
    Top-plate bore Ø23.75 -> Ø29.2 mm (bush_od 29 mm + bush_fit), so the
    5/8 clamp with its M3 cap heads (14.3 mm swept) drops through from
    above. New N20 bushings: Ø29.0 mm, Ø34 mm double-D flange (flats at
    ±14.4 mm, parallel to the side walls), retained from below; the flange
    recess is double-D too (±14.68 mm), so the side walls aren't undercut.
    Dowel bores unchanged. They differ from the MG90S bushings on purpose.
    Checks: swept r 14.45 clear of the mount from z 4.2 to 45; bushings x
    mount 0; wall relief clear; no new interferences. Box wall hole: Ø20 is
    fine if the dowel goes through the mount before mounting, otherwi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
    [N20_Bushing_025.stl, N20_Bushing_0625.stl, N20_Bushing_075.stl, N20_Mount.stl, cam-rotation-n20.f3d, cam-rotation-n20.step]
2026-11-03 N20: electronics cover fitted to the board as built
    RV1 stands on its pins (J10-J12 assumed) with its shaft parallel to the
    board, pointing off the J edge, and C3 stands over I7/I8; the docs had
    the pot shaft-up and C3 lying. The cover's J-edge wall moves in to
    0.3 mm past RV1's face (u 19.35-21.35) and carries the Ø7.2 mm knob
    hole at the shaft height, so the M7 nut and washer clamp it from
    outside (2.7 mm of thread left with the assumed 5 mm bushing). The top
    gets a notch for RV1's body and a hole for C3's top; the C1 hole, the
    USB-C opening, the posts and the motor notch stay. Still prints top
    plate down, no supports.
    All the sizes are named user parameters (rv1_*, c3_*, cover_*), most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
    [N20_Electronics_Cover.stl, cam-rotation-n20.f3d, cam-rotation-n20.step]
2026-11-03 N20 cover: measured knob height and reach, C3 like C1
    RV1's shaft centre is 5 mm above the board and its threaded bushing
    sticks out 5 mm past the board edge (measured). The J-edge wall stays
    0.3 mm past the board edge; the knob hole moves down to 5 mm, and an
    11.5 x 0.8 mm recess round it on the outside thins the wall to 1.2 mm at
    the nut, leaving 3.5 mm of thread for the M7 nut and washer (2.7 mm
    without it). The wall is now placed from the board edge, never over the
    board, whatever the pot's face position.
    C3 is the same 8 x 13 mm part as C1, standing 1.5 mm up over I7/I8; in
    the model its centre sits ~3 mm toward the J edge (assumed), clear of
    the DRV8833 and Super Mini, through a 9 mm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
    [N20_Electronics_Cover.stl, cam-rotation-n20.f3d, cam-rotation-n20.step]
2026-11-03 MG90S: the larger bushing bore and double-D bushings, shared with the N20
    The user wants both drives to take the assembled 5/8 clamp from above,
    so the MG90S drive (Cam Rotation Starter, Fusion version 50) gets the
    N20's change, copied deliberately: bush_od 29 mm, so the top-plate bore
    is Ø29.2; bushing flanges Ø34 with flats 28.8 mm apart; the flange
    recess filled back to the side walls (±14.68). Checks in that document:
    swept r 14.45 clear of the mount from z 4.2 to 45, the clamps (13.25 mm)
    pass, bushings x mount 0, no new interferences. Re-exported and oriented
    Servo_Mount and the three bushings, and the MG90S STEP/f3d.
    The bushings are a shared part again: the N20 docs drop 'differ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
    [Bushing_025.stl, Bushing_0625.stl, Bushing_075.stl, Servo_Mount.stl, cam-rotation-starter.f3d, cam-rotation-starter.step]
2026-11-03 Bushing goes in from the box-wall side, both drives
    The flange recess moves from the underside of the top plate to the
    mount's flat wall face (1.6 mm deep, bush_recess_depth), and the old
    recess is filled. The bushing drops into the bore from the wall side and
    the box wall retains it once the mount is screwed on, so nothing has to
    slide in under the plate past the 5/8 clamp. Bore, bushings and dowel
    bores are unchanged; only the mounts need reprinting.
    Fusion: Cam Rotation Starter version 51, Cam Rotation N20 version 35
    (36 rewords the bush_od comment). Assembly order updated in both READMEs
    and MG90S assembly steps 1 and 6; step1_bushing, exploded_full,
    xray_plusY and the N20 perfboard_cov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
    [N20_Mount.stl, Servo_Mount.stl, cam-rotation-n20.f3d, cam-rotation-n20.step, cam-rotation-starter.f3d, cam-rotation-starter.step]
2026-11-03 N20: mirror the perfboard to match the real board
    The model had the board as its own mirror image (rows toward +X with column
    A toward the box wall), so the printed cover only fit RV1 and C3. Rows now
    run toward -X: USB-C ports, open end, C1 hole, posts and motor notch move to
    the -X/+X ends they really occupy. Fusion Cam Rotation N20 version 36.
    - cover_rv1.py, wires.py: world x = 5.3 - v; cover_rv1 moves the timeline
    marker back to the end after editing the Perfboard base feature
    - W14/W15/W6/W11 rerouted; cut list and wiring docs updated
    - cover STL re-exported; board images re-rendered
    [N20_Electronics_Cover.stl, cut-list.csv]
2026-11-04 Firmware: bare XIAO board (BOOT button only, no pot or switch)
    New CamBox -> Board choice CAM_BOARD_XIAO_C6_BARE (sdkconfig.xiao-bare):
    GPIO9 (BOOT) is the panel button, the ADC and knob are not set up
    (BOARD_HAS_KNOB 0; knob_enabled forced false), and the web app hides
    the knob checkbox via a read-only has_knob setting. GPIO9 is a strapping
    pin, so the boot-time Wi-Fi reset is replaced by a 10 s hold while running.
    [app_main.c, board.h, controls.c, settings.c]
2026-11-04 Firmware: console `info` command
    Prints the device name, access point, STA/AP MACs, board and drive,
    firmware version and build time, IDF version and chip revision, so
    boards can be told apart over serial. Adds esp_app_format to main's
    requirements for the app description.
2026-11-04 Web: show the device name in the header
    The hostname (cambox-XXXX) now appears under the CamBox title and in
    the tab title, taken from the status stream, so several boxes are easy
    to tell apart.
2026-11-04 Web: regenerate the packed bundle in data/www
    npm run build output (gzipped, hashed assets) replaces the stale
    unzipped copies, and includes the device name in the header.
2026-11-10 N20: model the Hall encoder motor; trim the cartridge hooks to clear it
    Fusion Cam Rotation N20 version 38. encoder_motor.py builds N20_Encoder
    (board, magnet cap, 6-pin plug, wire keep-out) from caliper measurements
    of the MECCANIXITY 1:150 encoder gearmotor. Both snap hooks are cut off
    24.8 mm below the gearbox face, so the encoder board clears them by
    0.2 mm; the catch is unchanged and the lead-in is gone.
    Also fixes the README's USB-C direction (-X since version 36) and C1's
    position (on the perfboard).
    [N20_Cartridge.stl]
2026-11-10 N20: wire up and count the Hall encoder motor
    Wiring (docs only; the Fusion model is unchanged):
    - J4 is now the encoder board's 6-pin socket; the motor's own cable
    is soldered into the perfboard. No six free neighbouring rows exist
    on the right-hand side for a 6-pin header.
    - W24 M1 -> J3 (OUT3), W25 M2 -> J2 (OUT4), W26 GND -> J4 hole and
    W27 VCC -> J5 (free strips 4/5 right), with new underside links
    W30 (I4 -> E4, GND) and W31 (I5 -> H10, 3V3); W28 C1 -> I15 (GPIO0)
    and W29 C2 -> I13 (GPIO2), run over the modules under the cover.
    - C2 moves to the perfboard at I2/I3. W14, W15, the 2-pin header and
    the wire clamp are dropped.
    - wiring.md, perfboard.md, cut-list.csv, README; sc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
    [cut-list.csv]
2026-11-10 N20: route the encoder motor cable in the model (Fusion version 39)
    wires.py now draws the encoder motor's 6-wire cable W24-W29 from the
    encoder's plug (pins x +5 to -5, M1 to M2) past the base's -Y edge
    and through the cover's notch to J3, J2, J4, J5, I15 and I13, the
    links W30 (I4 -> E4) and W31 (I5 -> H10), and C2 standing at I2/I3.
    W14, W15 and C2 at the motor are gone, and the plain N20's 2-pin J4
    header body in the Perfboard is hidden.
    At the notch the wires lie at 1.04 mm pitch in landing order; between
    the plug and the base they are stacked across the run so the cross-
    overs don't touch. W28/W29 run 7.4 mm above the board. Interference
    check: no contact with any body (cover included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
    [cut-list.csv]
2026-11-10 N20: re-render the perfboard pictures and redraw the hole map for the encoder motor
    - shots.py: the encoder is part of the cartridge set, and the
    perfboard shot shows the motor cable W24-W29 and C2 in place of
    W14/W15. Re-rendered perfboard, perfboard_cover, wiring_electronics
    and wiring_under_base from Fusion version 39.
    - perfboard.svg: C2 at I2/I3 replaces the 2-pin J4 header; the six
    cable wires come in at the notch edge (J2-J5, and over the modules
    to I15/I13); underside links W30 and W31; the key moves to the
    lower left. Alt text and title block updated.
    - Alt text in wiring.md, perfboard.md and the README describes the
    new pictures; the "before the encoder motor" notes a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
    [shots.py]
2026-11-10 N20: clean up after the encoder motor
    - Drive README: M1 is the 1:150 Hall encoder motor (the plain 100:1
    kept as the earlier choice), the gear-ratio decision gives both, the
    zip-tie row and assembly step 8 no longer mention W14/W15 or the
    wire clamp. Top-level README: the N20 drive has an encoder.
    - STL README: the cartridge's wire clamp is unused with the encoder
    motor; version 39 changes wiring only.
    - shots.py: drop the motor_clamp shot; remove motor_clamp.png, which
    nothing links to.
    - cad/step: .step and .f3d re-exported from Fusion version 39 (they
    were version 35); cad/README says so.
    [cam-rotation-n20.f3d, cam-rotation-n20.step]
2026-11-10 N20 CAD README: version 37 is the board mirroring; version 40 changes no geometry
    The mirroring commit (843d168) called it version 36, but Fusion saved it as
    37; 36 is the bush_od comment. Version 40 is a plain save after the renders.
    Every printed part in it matches its STL's volume to within 0.1%, so the STL
    set and the version 39 step/ snapshots stand.
2026-11-10 N20: cartridge fingers catch the encoder board (Fusion version 41)
    The version 38 cartridge wouldn't clip over the encoder motor: its hooks
    had to drop into a gap under 1 mm wide between the end cap and the board,
    which sits tilted 25-25.5 mm from the gearbox face.
    - -Y arm: the end-cap hook is gone; two 1.2 mm fingers, split from the
    arm up to z -15, pass the board's sides 0.3 mm clear and catch its back
    at 26.6 mm, 0.8 mm in, with a lead-in. The +x catch is tapered 45
    degrees so it prints without supports.
    - +Y arm: keeps its end-cap hook, with a 0.5 mm lead-in again.
    - Re-exported N20_Cartridge.stl and the STEP/f3d snapshots from v41;
    encoder_fingers.py is the script that built t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
    [N20_Cartridge.stl, cam-rotation-n20.f3d, cam-rotation-n20.step]
2026-11-10 N20 cartridge print notes: PETG, no supports; organic and PLA interface if any
    Standard supports fill the gearbox cavity and the encoder-finger slots and
    are close to impossible to remove. The cartridge's only real ceiling is the
    cavity's far wall, a 10.6 mm bridge, so it prints without supports.
2026-11-10 Record a story by turning the shaft by hand, and play it back closed-loop
    Teach mode (N20 with the Hall encoder, Super Mini build):
    - player_teach_start/stop/cancel: the DRV8833 sleeps (servo_release),
    so the gearbox turns freely, and the encoder is sampled at 25 Hz for
    up to 120 s. Stop trims the still time at each end and returns the
    take as a story.
    - track.c: a story's "track" is {"hz", "cpr", "d"}, with "d" the
    count changes as one comma-separated string (no cJSON number items).
    Beats are worked out from the motion (Douglas-Peucker to at most 64
    runs, or 64 equal slices if that follows it better), so builds
    without an encoder still play it.
    - Playback: a story with a track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
